hotchk155/cvocd.a/asp_config/img/cvocd.gif

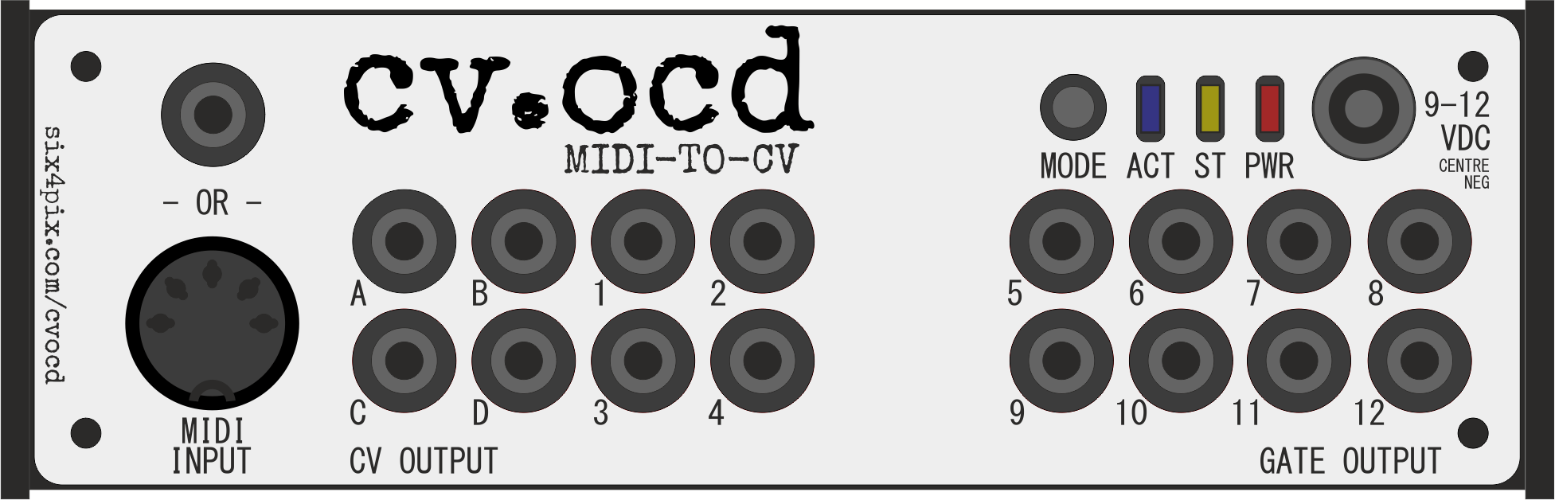
asp_config/img/cvocd.gif
