hotchk155/cvocd.a/cvocd_banana_fascia/bot-mask.bmp

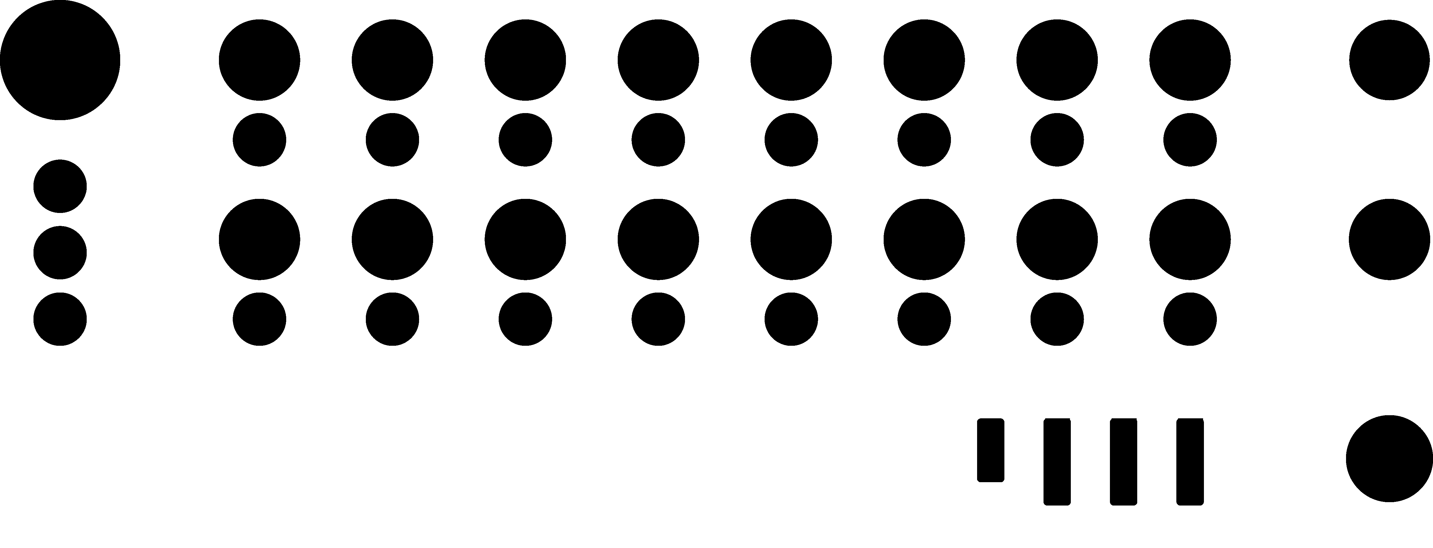
cvocd_banana_fascia/bot-mask.bmp
