hotchk155/cvocd.a/cvocd_banana_fascia/top-copper.bmp

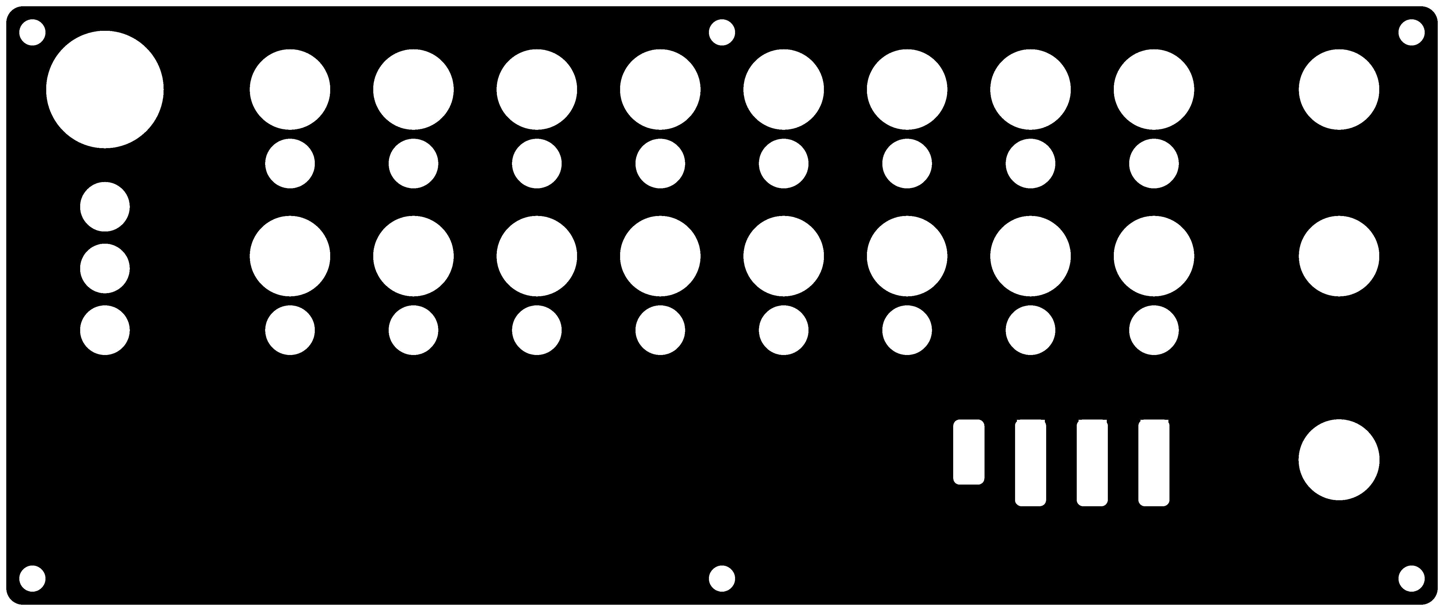
cvocd_banana_fascia/top-copper.bmp
