hotchk155/cvocd.a/cvocd_banana_fascia/top-silk.bmp

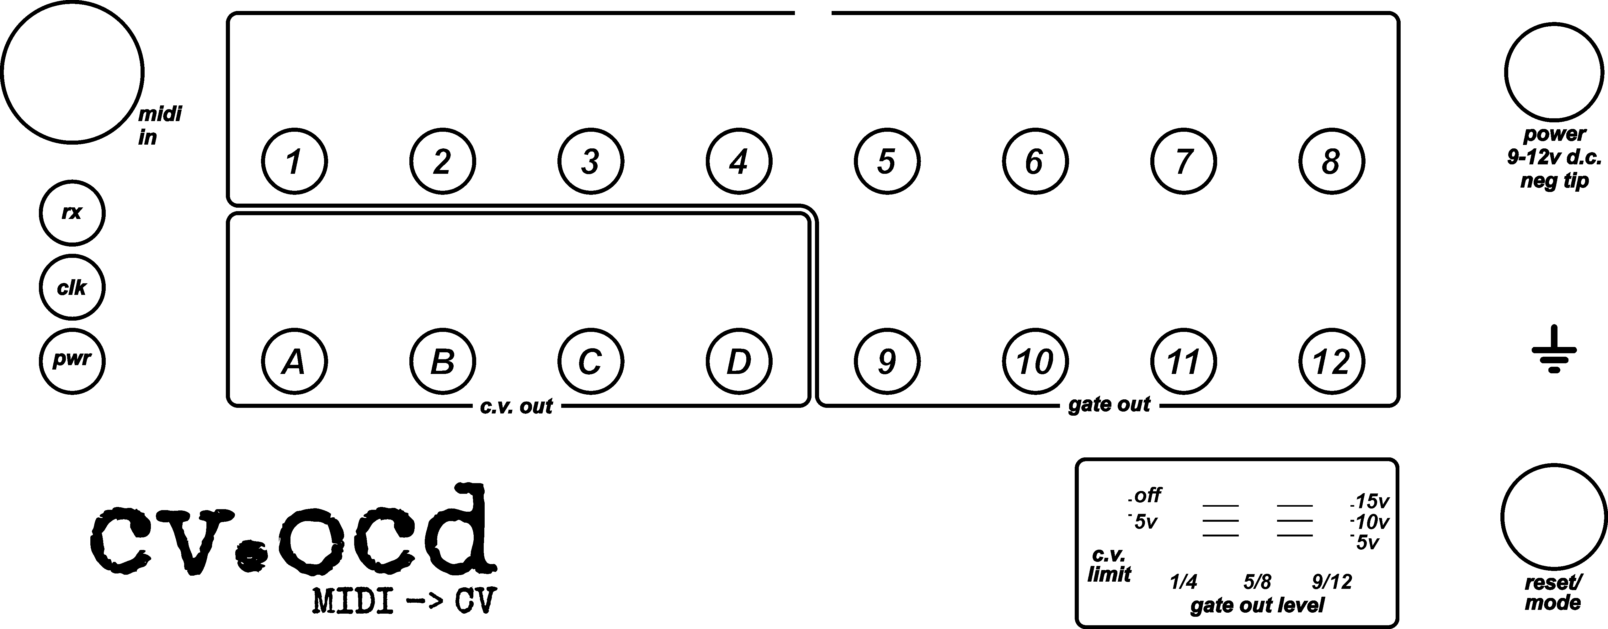
cvocd_banana_fascia/top-silk.bmp
