hotchk155/cvocd.a/hardware/cvocd.bmp

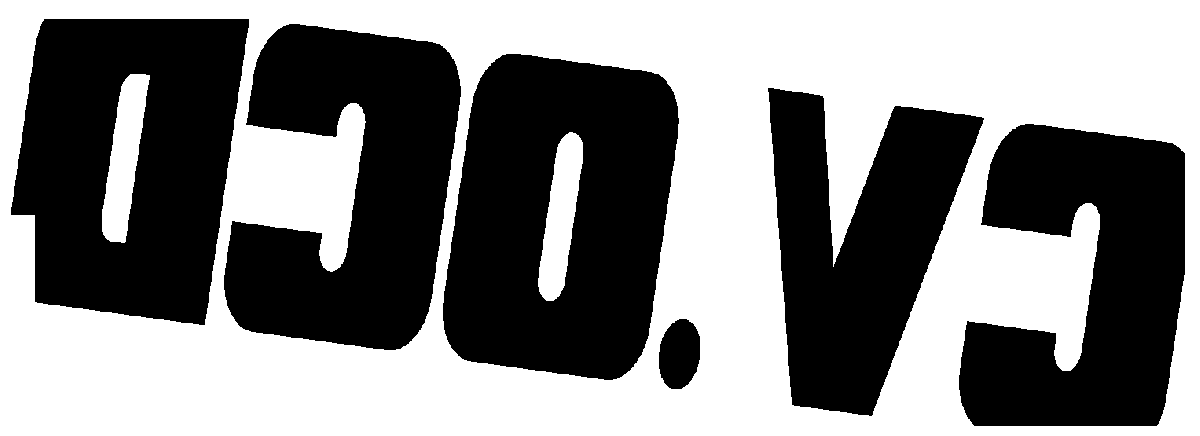
hardware/cvocd.bmp
