hotchk155/cvocd.a/cvocd_banana/cvb_bom.xlsx

Designator | Footprint |  | Quantity | Designation | 50 |  | per unit
C1, C2, C7, C8, C13, C14, C19, C20, C21, C27, C28 | C0805 | 100n | 12 | 100n | 600 | 0.02 | 0.24
C22, C23, C26, C29 | D CASE | 100uF | 4 | TAJD107K020SNTV | 200 | 0.43 | 1.72
C24, C25 | C0805 | 1uF | 2 | CL21B105KAFNNNG | 100 | 0.02 | 0.04
C3, C4, C5, C6, C9, C10, C11, C12, C15, C16, C17, C18 | C0805 | 10n | 12 | 10n | 600 | 0.2 | 2.4
CVA, CVB, CVC, CVD | 108-0910-001 |  | 4 | Banana Blue | 200 | 0.68 | 2.72
D1, D2, D3, D4 | D0805 |  | 4 | BZY55B5V1 RBG | 200 | 0.1 | 0.4
D5, D6, D7, D8, D9 | SOD123 |  | 5 | MBR0520LT | 250 | 0.09 | 0.45
GND | 108-0903-001 |  | 1 | Banana Black | 50 | 0.68 | 0.68
GT1, GT2, GT3, GT4, GT5, GT6, GT7, GT8, GT9, GT10, GT11, GT12 | 108-0902-001 |  | 12 | Banana Red | 600 | 0.65 | 7.8
IC3, IC1, IC2 | SOIC16 |  | 3 | MC14504BDR2G | 150 | 0.3 | 0.9
IC4 | SOIC14 |  | 1 | LM324BIDR | 50 | 0.12 | 0.12
IC5 | SOT223 |  | 1 | TLV76150DCYR | 50 | 0.23 | 0.23
IC6 | SOT-23-5 |  | 1 | AP3012KTR-E1 | 50 | 0.25 | 0.25
IC7 | SOT223 |  | 1 | LM317MBSTT3G | 50 | 0.2 | 0.2
L1 |  |  | 1 | TYS4012100M-10 | 50 | 0.29 | 0.29
L2 |  |  | 1 | CM322522-1R0KL | 50 | 0.15 | 0.15
LCV1, LCV2, LCV3, LCV4, LG1, LG2, LG3, LG4, LG5, LG6, LG7, LG8, LG9, LG10, LG11, LG12, LPOWER | 3258 Reverse Mount |  | 17 | LED RED | 850 | 0.06 | 1.02
LMIDI1 | 3258 Reverse Mount |  | 1 | LED BLUE | 50 | 0.06 | 0.06
LSTATUS1 | 3258 Reverse Mount |  | 1 | LED YELLOW | 50 | 0.06 | 0.06
MIDI SOCKET |  |  | 1 |  | 50 | 0.5 | 0.5
POWER SOCKET |  |  | 1 |  | 50 | 0.78 | 0.78
PUSH BUTTON |  |  | 1 |  | 50 | 1.08 | 1.08
Q2,Q1,Q4,Q3 | SOT-23 |  | 4 | 2N7002 | 200 | 0.16 | 0.64
R1, R2, R3, R4 R5, R6, R7, R8, R9, R10, R11, R12, R13, R14, R15, R16, R17, R18, R19, R20, R21, R22, R23, R24, R26, R28, R30, R32, R33, R34, R35 | R0805 |  | 31 | 1k | 1550 | 0.01 | 0.31
R25,R27,R29,R31 | R0805 |  | 4 | 4k7 | 200 | 0.01 | 0.04
R36 | R0805 |  | 1 | 22k | 50 | 0.01 | 0.01
R37 | R0805 |  | 1 | 2k | 50 | 0.01 | 0.01
R38 | R0805 |  | 1 | 470R | 50 | 0.01 | 0.01
R39 | R0805 |  | 1 | 3K3 | 50 | 0.01 | 0.01
R40 | R0805 |  | 1 | 10k | 50 | 0.01 | 0.01
SW1, SW2, SW3 | CL-SB-13B-02T |  | 3 | SW_SP3T | 150 | 0.95 | 2.85
SW4 | CL-SB-12B-01T |  | 1 | SW_SPDT | 50 | 0.65 | 0.65
Spacer | M3 20mm F/F |  | 6 |  | 300 | 0.13 | 0.78
 |  |  |  |  |  |  | 27.41
