hotchk155/cvocd.a/test-rig/cv cal setup.docx

CVOCD CALIBRATION RIG SETUP

Adjust 4.096V reference

For each output

Connect to the GND reference output

Check voltage at the lower white pin

Adjust until zero

For each output

Connect to the 4.096V reference output

Check voltage at the ADC input pin

Adjust until 2.048
