hotchk155/cvocd.a/docs/manual/img/advancednote.gif

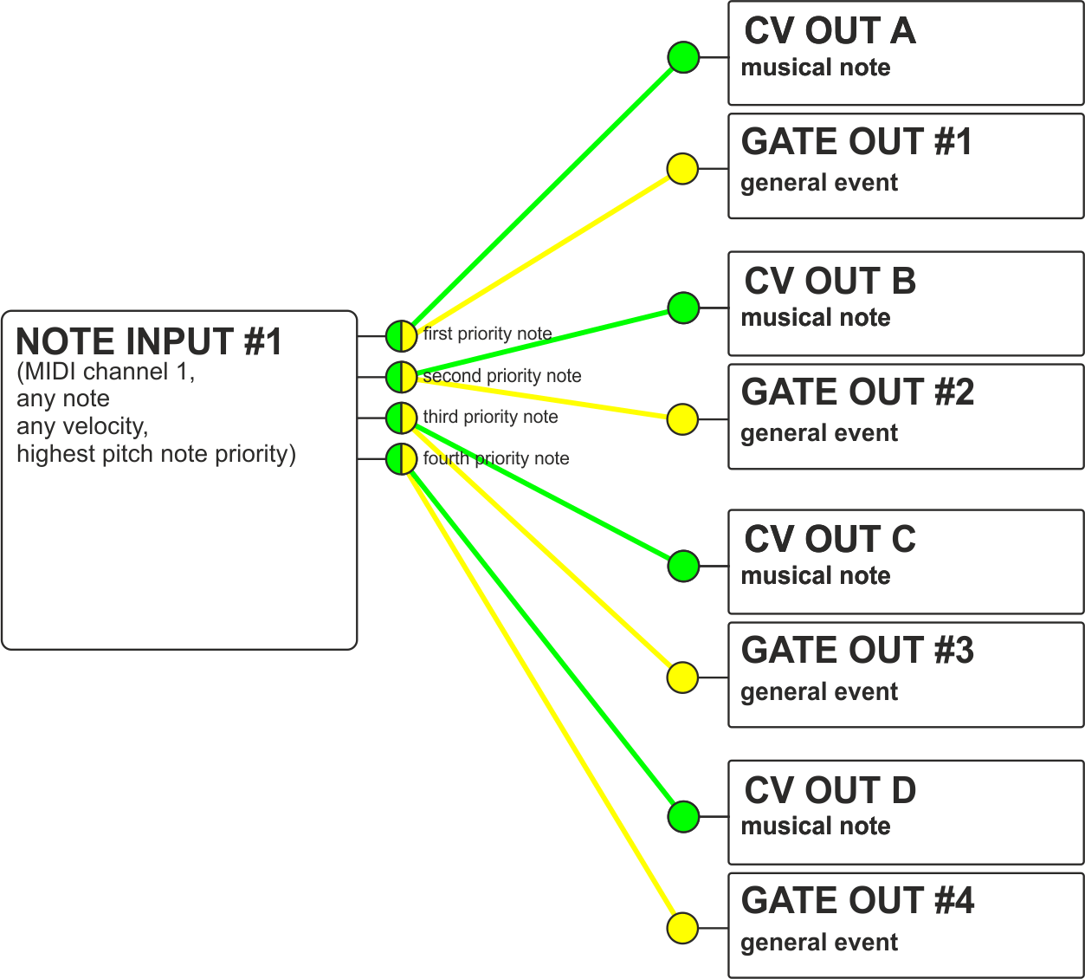
docs/manual/img/advancednote.gif
