hotchk155/cvocd.a/docs/manual/img/basicnote.gif

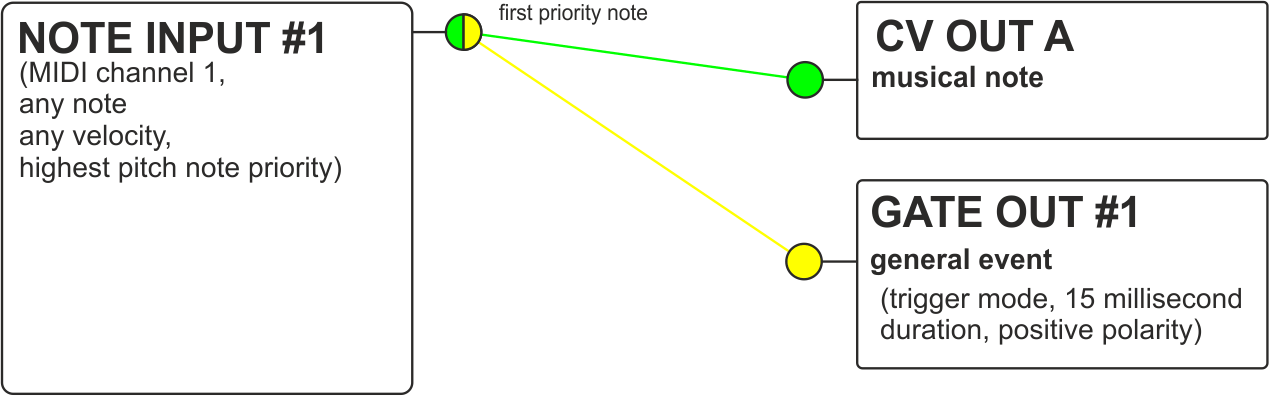
docs/manual/img/basicnote.gif
