hotchk155/cvocd.a/docs/manual/img/config1.gif

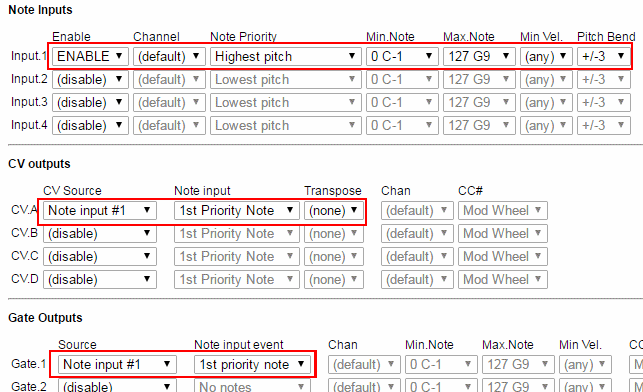
docs/manual/img/config1.gif
