hotchk155/cvocd.a/docs/manual/img/config2.gif

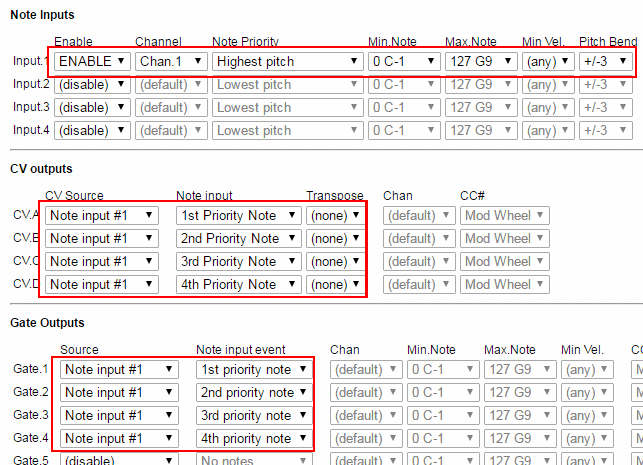
docs/manual/img/config2.gif
