hotchk155/cvocd.a/docs/manual/img/config8.gif

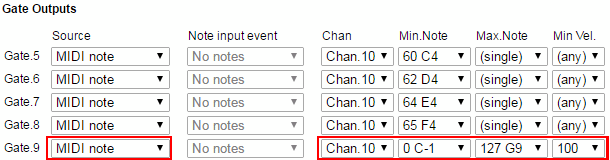
docs/manual/img/config8.gif
