hotchk155/cvocd.a/docs/manual/img/config12.gif

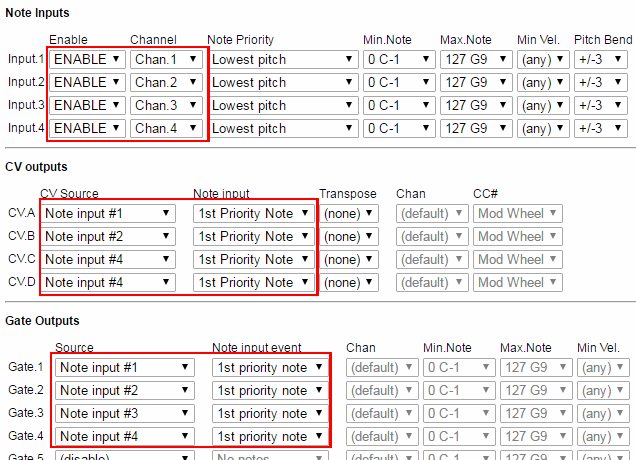
docs/manual/img/config12.gif
