hotchk155/cvocd.a/docs/manual/img/config13.gif

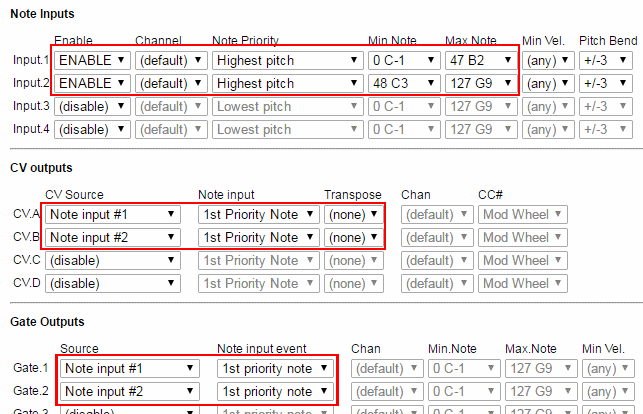
docs/manual/img/config13.gif
