hotchk155/cvocd.a/docs/manual/img/mappings.gif

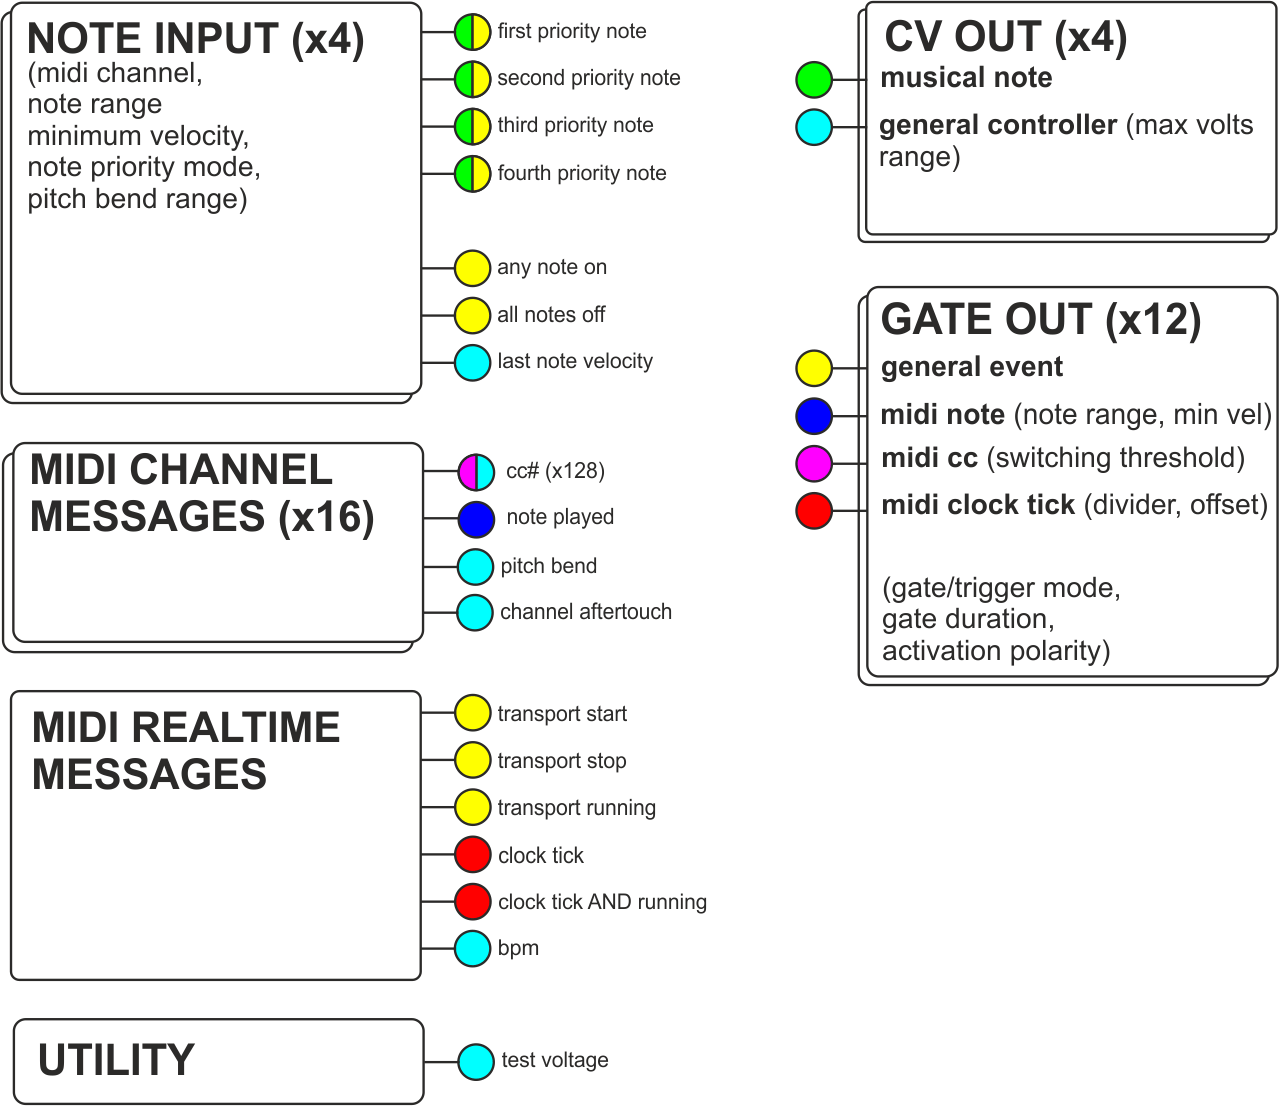
docs/manual/img/mappings.gif
