hotchk155/cvocd.a/cvocd_banana/cvocd_banana.kicad_pcb

## KiCad design cvocd_banana/cvocd_banana.kicad_pcb (2026-04-23)

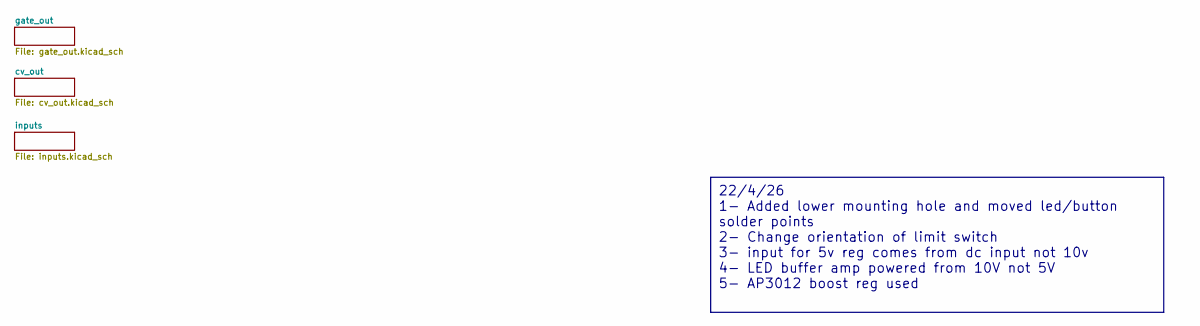
[picture p21: schematic cvocd_banana.kicad_sch]

Notes on the sheet:
22/4/26 1- Added lower mounting hole and moved led/button solder points 2- Change orientation of limit switch 3- input for 5v reg comes from dc input not 10v 4- LED buffer amp powered from 10V not 5V 5- AP3012 boost reg used

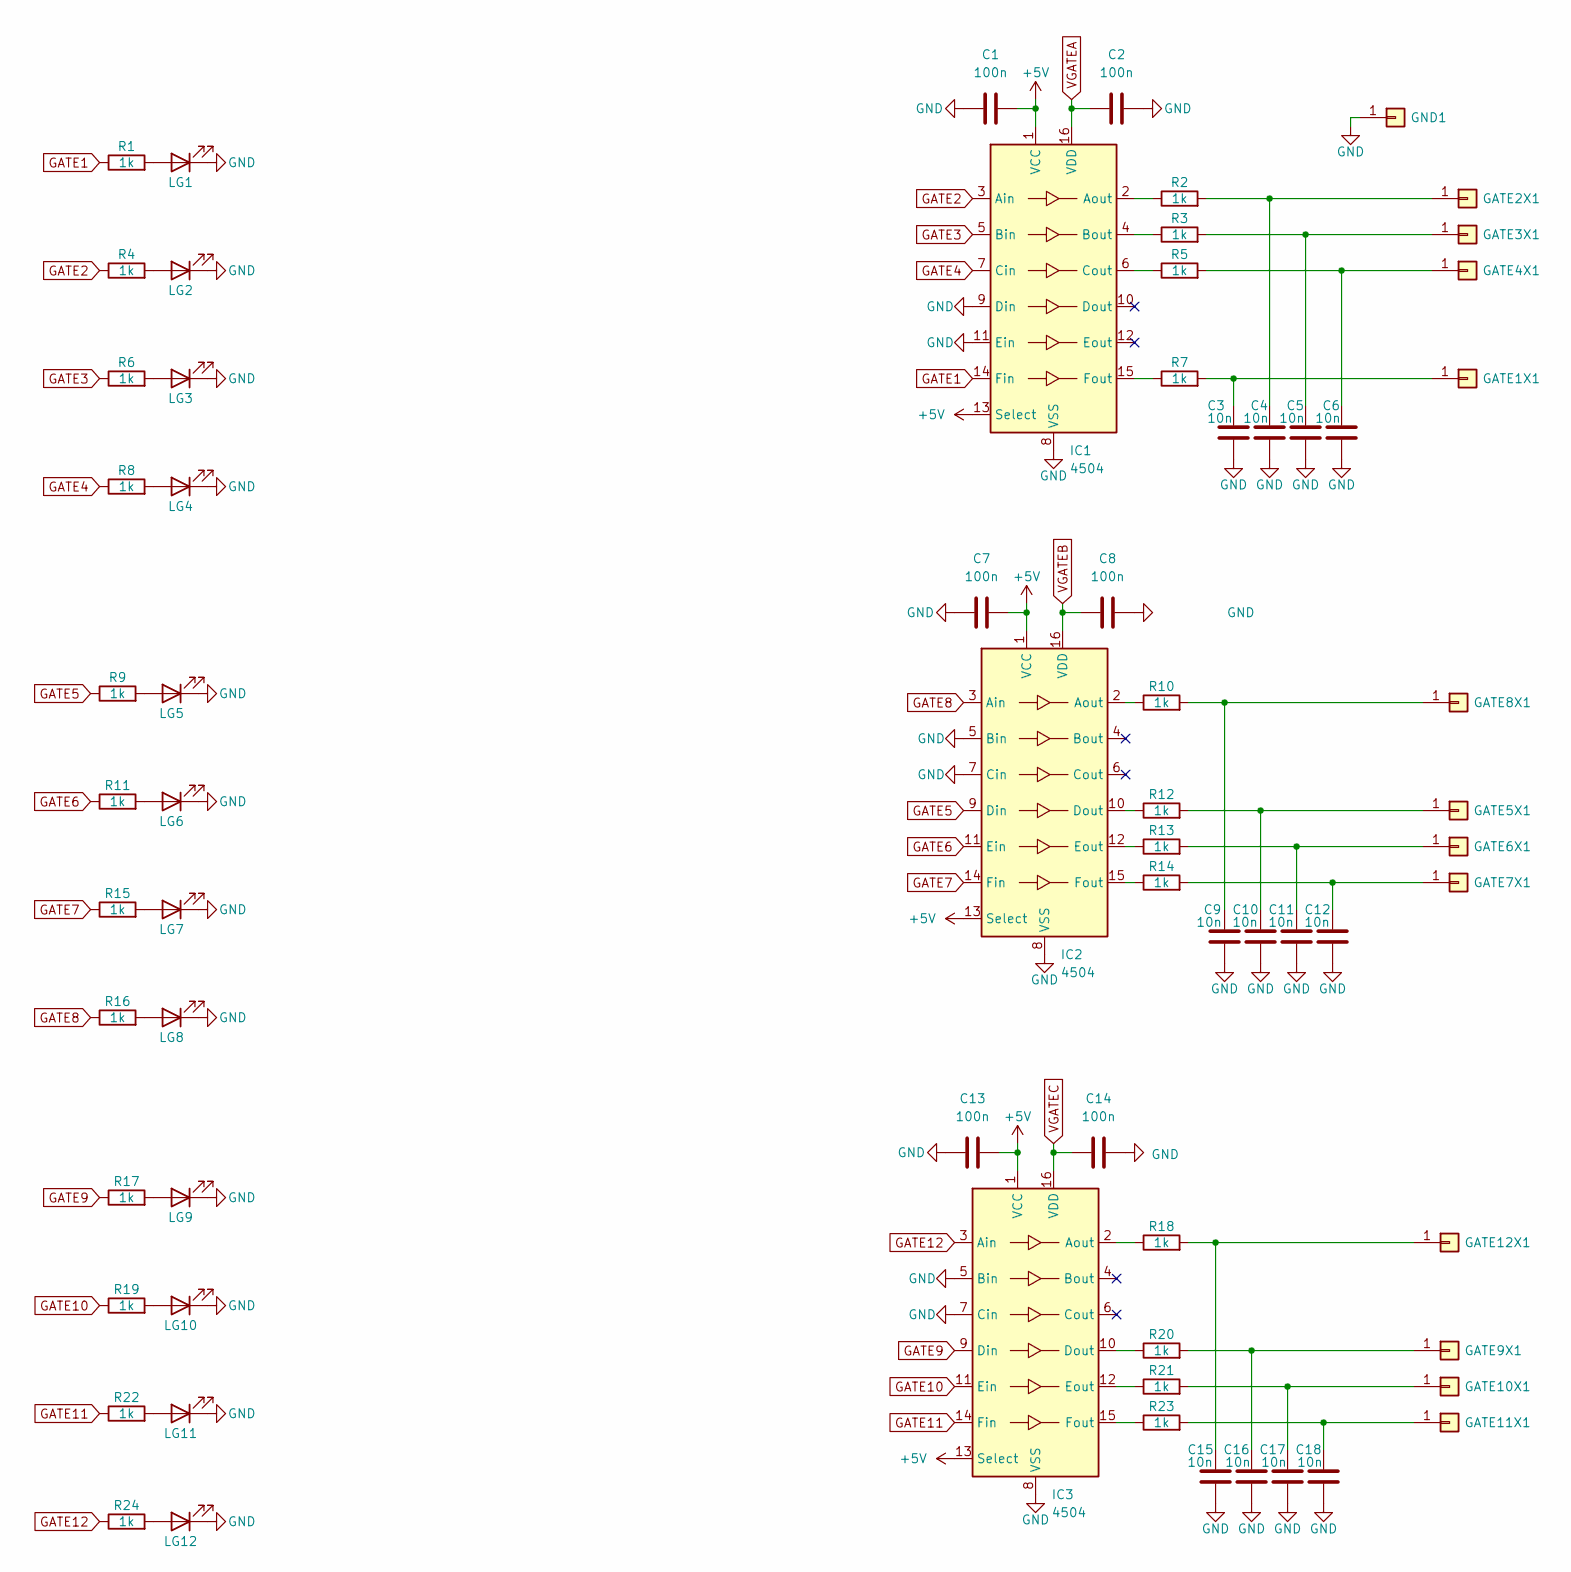
[picture p22: schematic gate_out.kicad_sch]

Parts:
C1, C2, C7, C8, C13, C14: 100n; C_0805_2012Metric
C3, C4, C5, C6, C9, C10, C11, C12, C15, C16, C17, C18: 10n; C_0805_2012Metric
GATE1X1, GATE2X1, GATE3X1, GATE4X1, GATE5X1, GATE6X1, GATE7X1, GATE8X1, GATE9X1, GATE10X1, GATE11X1, GATE12X1: Conn_01x01; CINCH-BANANA
GND1: Conn_01x01; CINCH-BANANA
IC1, IC2, IC3: 4504; SOIC-16_3.9x9.9mm_P1.27mm
LG1, LG2, LG3, LG4, LG5, LG6, LG7, LG8, LG9, LG10, LG11, LG12: LED; 3528_ReverseMount_LED
R1, R2, R3, R4, R5, R6, R7, R8, R9, R10, R11, R12, R13, R14, R15, R16, R17, R18, R19, R20, R21, R22, R23, R24: 1k; R_0805_2012Metric

Connections:
+5V: C1.2, C7.2, C13.2, IC1.1 (VCC), IC1.13 (Select), IC2.1 (VCC), IC2.13 (Select), IC3.1 (VCC), IC3.13 (Select); also elsewhere on the board
GATE1: IC1.14 (Fin), R1.1; also elsewhere on the board
GATE2: IC1.3 (Ain), R4.1; also elsewhere on the board
GATE3: IC1.5 (Bin), R6.1; also elsewhere on the board
GATE4: IC1.7 (Cin), R8.1; also elsewhere on the board
GATE5: IC2.9 (Din), R9.1; also elsewhere on the board
GATE6: IC2.11 (Ein), R11.1; also elsewhere on the board
GATE7: IC2.14 (Fin), R15.1; also elsewhere on the board
GATE8: IC2.3 (Ain), R16.1; also elsewhere on the board
GATE9: IC3.9 (Din), R17.1; also elsewhere on the board
GATE10: IC3.11 (Ein), R19.1; also elsewhere on the board
GATE11: IC3.14 (Fin), R22.1; also elsewhere on the board
GATE12: IC3.3 (Ain), R24.1; also elsewhere on the board
GND: C1.1, C2.2, C3.1, C4.1, C5.1, C6.1, C7.1, C8.2, C9.1, C10.1, C11.1, C12.1, C13.1, C14.2, C15.1, C16.1, C17.1, C18.1, GND1.1, IC1.8 (VSS), IC1.9 (Din), IC1.11 (Ein), IC2.5 (Bin), IC2.7 (Cin), IC2.8 (VSS), IC3.5 (Bin), IC3.7 (Cin), IC3.8 (VSS), LG1.1 (K), LG2.1 (K), LG3.1 (K), LG4.1 (K), LG5.1 (K), LG6.1 (K), LG7.1 (K), LG8.1 (K), LG9.1 (K), LG10.1 (K), LG11.1 (K), LG12.1 (K); also elsewhere on the board
unnamed: C3.2, GATE1X1.1, R7.2
unnamed: C4.2, GATE2X1.1, R2.2
unnamed: C5.2, GATE3X1.1, R3.2
unnamed: C6.2, GATE4X1.1, R5.2
unnamed: C10.2, GATE5X1.1, R12.2
unnamed: C11.2, GATE6X1.1, R13.2
unnamed: C12.2, GATE7X1.1, R14.2
unnamed: C9.2, GATE8X1.1, R10.2
unnamed: C16.2, GATE9X1.1, R20.2
unnamed: C17.2, GATE10X1.1, R21.2
unnamed: C18.2, GATE11X1.1, R23.2
unnamed: C15.2, GATE12X1.1, R18.2
unnamed: IC1.2 (Aout), R2.1
unnamed: IC1.4 (Bout), R3.1
unnamed: IC1.6 (Cout), R5.1
unnamed: IC1.15 (Fout), R7.1
unnamed: IC2.2 (Aout), R10.1
unnamed: IC2.10 (Dout), R12.1
unnamed: IC2.12 (Eout), R13.1
unnamed: IC2.15 (Fout), R14.1
unnamed: IC3.2 (Aout), R18.1
unnamed: IC3.10 (Dout), R20.1
unnamed: IC3.12 (Eout), R21.1
unnamed: IC3.15 (Fout), R23.1
unnamed: LG1.2 (A), R1.2
unnamed: LG2.2 (A), R4.2
unnamed: LG3.2 (A), R6.2
unnamed: LG4.2 (A), R8.2
unnamed: LG5.2 (A), R9.2
unnamed: LG6.2 (A), R11.2
unnamed: LG7.2 (A), R15.2
unnamed: LG8.2 (A), R16.2
unnamed: LG9.2 (A), R17.2
unnamed: LG10.2 (A), R19.2
unnamed: LG11.2 (A), R22.2
unnamed: LG12.2 (A), R24.2
VGATEA: C2.1, IC1.16 (VDD); also elsewhere on the board
VGATEB: C8.1, IC2.16 (VDD); also elsewhere on the board
VGATEC: C14.1, IC3.16 (VDD); also elsewhere on the board

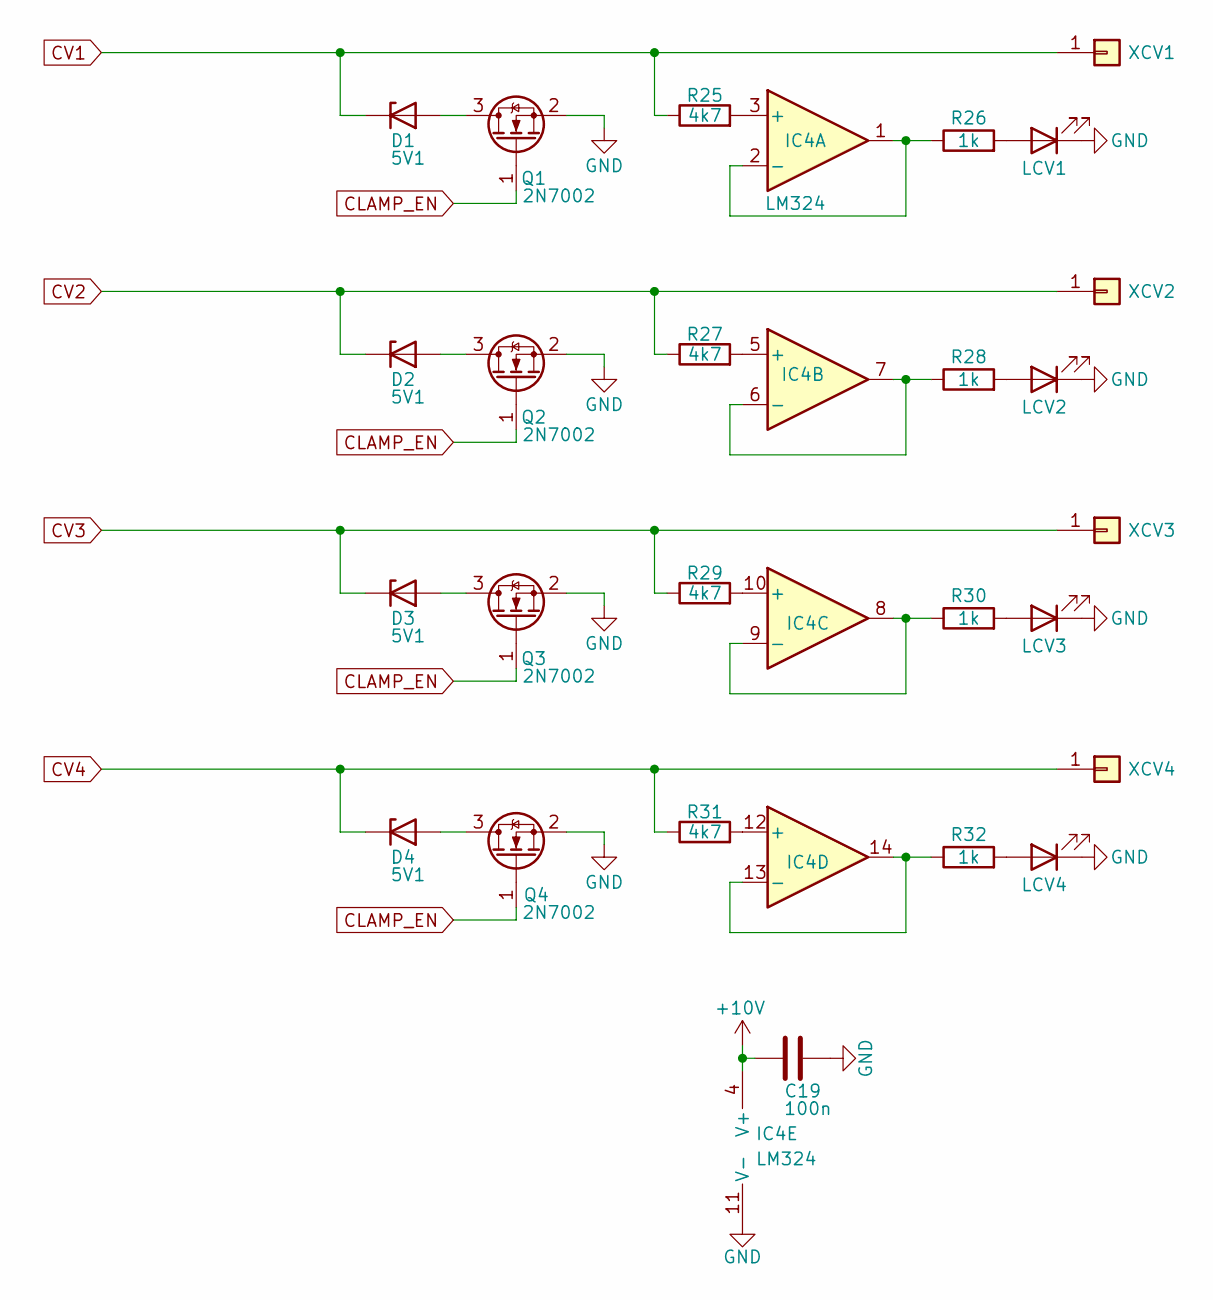
[picture p23: schematic cv_out.kicad_sch]

Parts:
C19: 100n; C_0805_2012Metric
D1, D2, D3, D4: 5V1; D_0805_2012Metric
IC4: LM324; SO-14_3.9x8.65mm_P1.27mm
LCV1, LCV2, LCV3, LCV4: LED; 3528_ReverseMount_LED
Q1, Q2, Q3, Q4: 2N7002; SOT-23
R25, R27, R29, R31: 4k7; R_0805_2012Metric
R26, R28, R30, R32: 1k; R_0805_2012Metric
XCV1, XCV2, XCV3, XCV4: Conn_01x01; CINCH-BANANA

Connections:
+10V: C19.1, IC4.4 (V+); also elsewhere on the board
CLAMP_EN: Q1.1 (G), Q2.1 (G), Q3.1 (G), Q4.1 (G); also elsewhere on the board
CV1: D1.1 (K), R25.1, XCV1.1; also elsewhere on the board
CV2: D2.1 (K), R27.1, XCV2.1; also elsewhere on the board
CV3: D3.1 (K), R29.1, XCV3.1; also elsewhere on the board
CV4: D4.1 (K), R31.1, XCV4.1; also elsewhere on the board
GND: C19.2, IC4.11 (V-), LCV1.1 (K), LCV2.1 (K), LCV3.1 (K), LCV4.1 (K), Q1.2 (S), Q2.2 (S), Q3.2 (S), Q4.2 (S); also elsewhere on the board
unnamed: D1.2 (A), Q1.3 (D)
unnamed: D2.2 (A), Q2.3 (D)
unnamed: D3.2 (A), Q3.3 (D)
unnamed: D4.2 (A), Q4.3 (D)
unnamed: IC4.3 (+), R25.2
unnamed: IC4.1, IC4.2 (-), R26.1
unnamed: IC4.5 (+), R27.2
unnamed: IC4.6 (-), IC4.7, R28.1
unnamed: IC4.10 (+), R29.2
unnamed: IC4.8, IC4.9 (-), R30.1
unnamed: IC4.12 (+), R31.2
unnamed: IC4.13 (-), IC4.14, R32.1
unnamed: LCV1.2 (A), R26.2
unnamed: LCV2.2 (A), R28.2
unnamed: LCV3.2 (A), R30.2
unnamed: LCV4.2 (A), R32.2

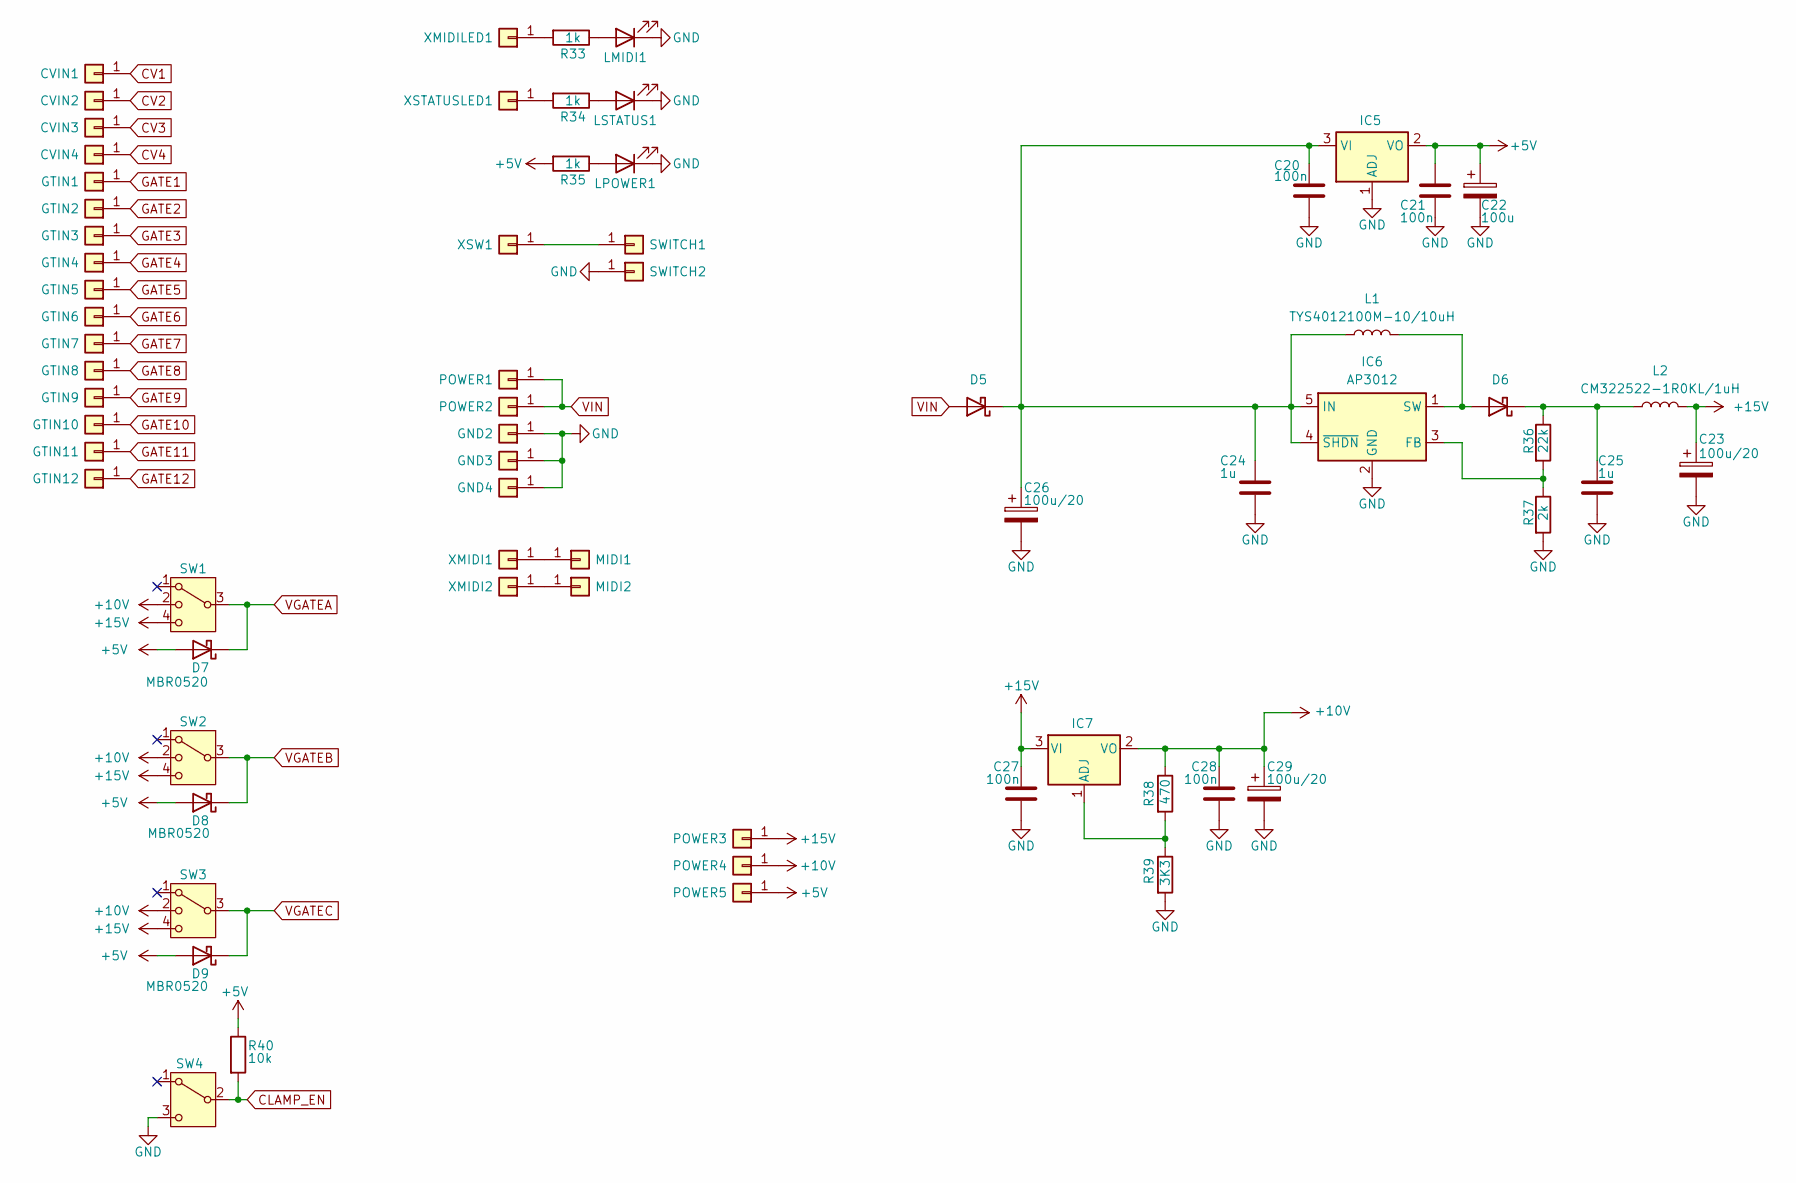
[picture p24: schematic inputs.kicad_sch]

Parts:
C20, C21, C27, C28: 100n; C_0805_2012Metric
C22: 100u; CP_EIA-7343-31_Kemet-D
C23, C26, C29: 100u/20; CP_EIA-7343-31_Kemet-D
C24, C25: 1u; C_0805_2012Metric
CVIN1, CVIN2, CVIN3, CVIN4: Conn_01x01; WireToBoardCVOCD
D5, D6: D_Schottky; D_SOD-123
D7, D8, D9: MBR0520; D_SOD-123
GND2, GND3, GND4: Conn_01x01; WireToBoardCVOCD
GTIN1, GTIN2, GTIN3, GTIN4, GTIN5, GTIN6, GTIN7, GTIN8, GTIN9, GTIN10, GTIN11, GTIN12: Conn_01x01; WireToBoardCVOCD
IC5: AMS1117; SOT-223-3_TabPin2
IC6: AP3012; SOT-23-5
IC7: LM317L_SOT-89; SOT-223-3_TabPin2
L1: TYS4012100M-10/10uH; L_Taiyo-Yuden_MD-4040
L2: CM322522-1R0KL/1uH; L_1210_3225Metric
LMIDI1: LED; 3528_ReverseMount_LED
LPOWER1: LED; 3528_ReverseMount_LED
LSTATUS1: LED; 3528_ReverseMount_LED
MIDI1, MIDI2: Conn_01x01; WireToBoardCVOCD
POWER1, POWER2, POWER3, POWER4, POWER5: Conn_01x01; WireToBoardCVOCD
R33, R34, R35: 1k; R_0805_2012Metric
R36: 22k; R_0805_2012Metric
R37: 2k; R_0805_2012Metric
R38: 470; R_0805_2012Metric
R39: 3K3; R_0805_2012Metric
R40: 10k; R_0805_2012Metric
SW1, SW2, SW3: SW_SP3T; Slide_1P3T_Rev_Mnt_CLSB13B01
SW4: SW_SPDT; Slide_1P2T_Rev_Mnt_CLSB12B01
SWITCH1, SWITCH2: Conn_01x01; WireToBoardCVOCD
XMIDI1, XMIDI2: Conn_01x01; WireToBoardCVOCD
XMIDILED1: Conn_01x01; WireToBoardCVOCD
XSTATUSLED1: Conn_01x01; WireToBoardCVOCD
XSW1: Conn_01x01; WireToBoardCVOCD

Connections:
+5V: C21.1, C22.1, D7.2 (A), D8.2 (A), D9.2 (A), IC5.2 (VO), POWER5.1, R35.2, R40.1; also elsewhere on the board
+10V: C28.1, C29.1, IC7.2 (VO), POWER4.1, R38.1, SW1.2, SW2.2, SW3.2; also elsewhere on the board
+15V: C23.1, C27.1, IC7.3 (VI), L2.2, POWER3.1, SW1.4, SW2.4, SW3.4
CLAMP_EN: R40.2, SW4.2 (B); also elsewhere on the board
CV1: CVIN1.1; also elsewhere on the board
CV2: CVIN2.1; also elsewhere on the board
CV3: CVIN3.1; also elsewhere on the board
CV4: CVIN4.1; also elsewhere on the board
GATE1: GTIN1.1; also elsewhere on the board
GATE2: GTIN2.1; also elsewhere on the board
GATE3: GTIN3.1; also elsewhere on the board
GATE4: GTIN4.1; also elsewhere on the board
GATE5: GTIN5.1; also elsewhere on the board
GATE6: GTIN6.1; also elsewhere on the board
GATE7: GTIN7.1; also elsewhere on the board
GATE8: GTIN8.1; also elsewhere on the board
GATE9: GTIN9.1; also elsewhere on the board
GATE10: GTIN10.1; also elsewhere on the board
GATE11: GTIN11.1; also elsewhere on the board
GATE12: GTIN12.1; also elsewhere on the board
GND: C20.2, C21.2, C22.2, C23.2, C24.2, C25.2, C26.2, C27.2, C28.2, C29.2, GND2.1, GND3.1, GND4.1, IC5.1 (ADJ), IC6.2 (GND), LMIDI1.1 (K), LPOWER1.1 (K), LSTATUS1.1 (K), R37.2, R39.2, SW4.3 (C), SWITCH2.1; also elsewhere on the board
unnamed: C20.1, C24.1, C26.1, D5.1 (K), IC5.3 (VI), IC6.4 (~SHDN), IC6.5 (IN), L1.1
unnamed: D6.2 (A), IC6.1 (SW), L1.2
unnamed: C25.1, D6.1 (K), L2.1, R36.1
unnamed: IC6.3 (FB), R36.2, R37.1
unnamed: IC7.1 (ADJ), R38.2, R39.1
unnamed: LMIDI1.2 (A), R33.1
unnamed: LPOWER1.2 (A), R35.1
unnamed: LSTATUS1.2 (A), R34.1
unnamed: MIDI1.1, XMIDI1.1
unnamed: MIDI2.1, XMIDI2.1
unnamed: SWITCH1.1, XSW1.1
unnamed: R33.2, XMIDILED1.1
unnamed: R34.2, XSTATUSLED1.1
VGATEA: D7.1 (K), SW1.3; also elsewhere on the board
VGATEB: D8.1 (K), SW2.3; also elsewhere on the board
VGATEC: D9.1 (K), SW3.3; also elsewhere on the board
VIN: D5.2 (A), POWER1.1, POWER2.1

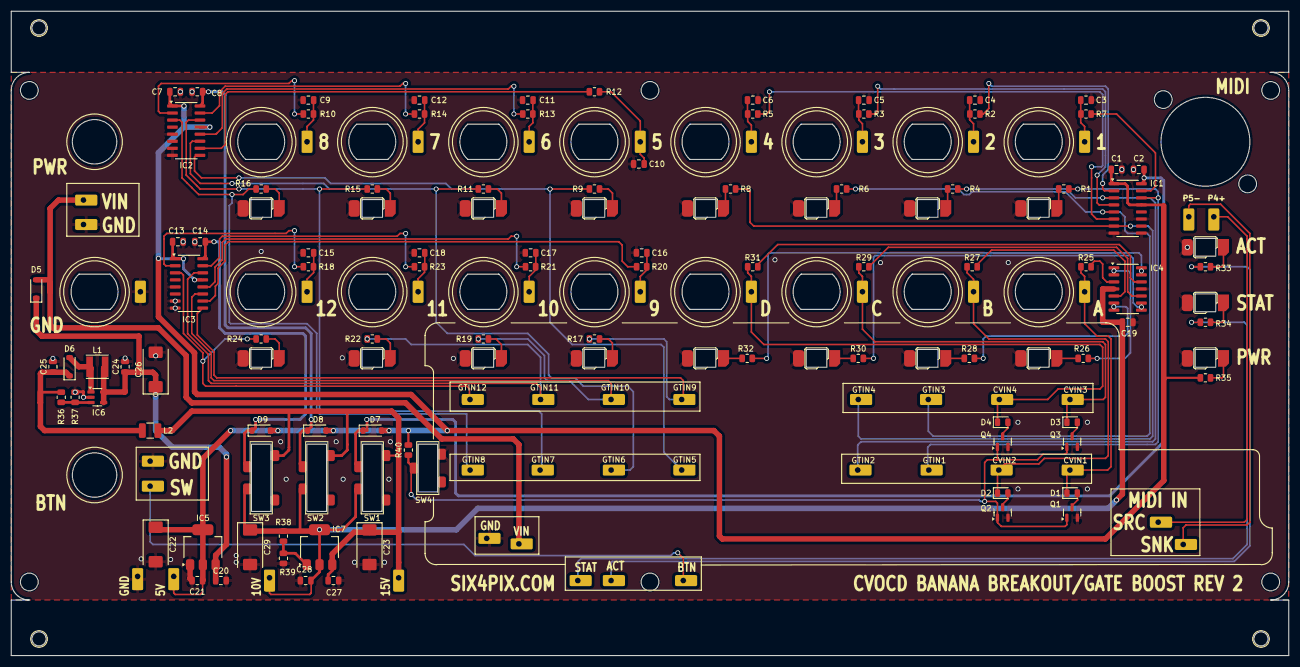
[picture p25: board cvocd_banana.kicad_pcb from above]

Board: 2 copper layers, 230.0 x 116.0 mm, 164 parts (0 on the bottom side), 90 nets.
