hotchk155/cvocd.a/hardware/cvocd-a.brd

## EAGLE design hardware/cvocd-a.brd (2020-03-26)

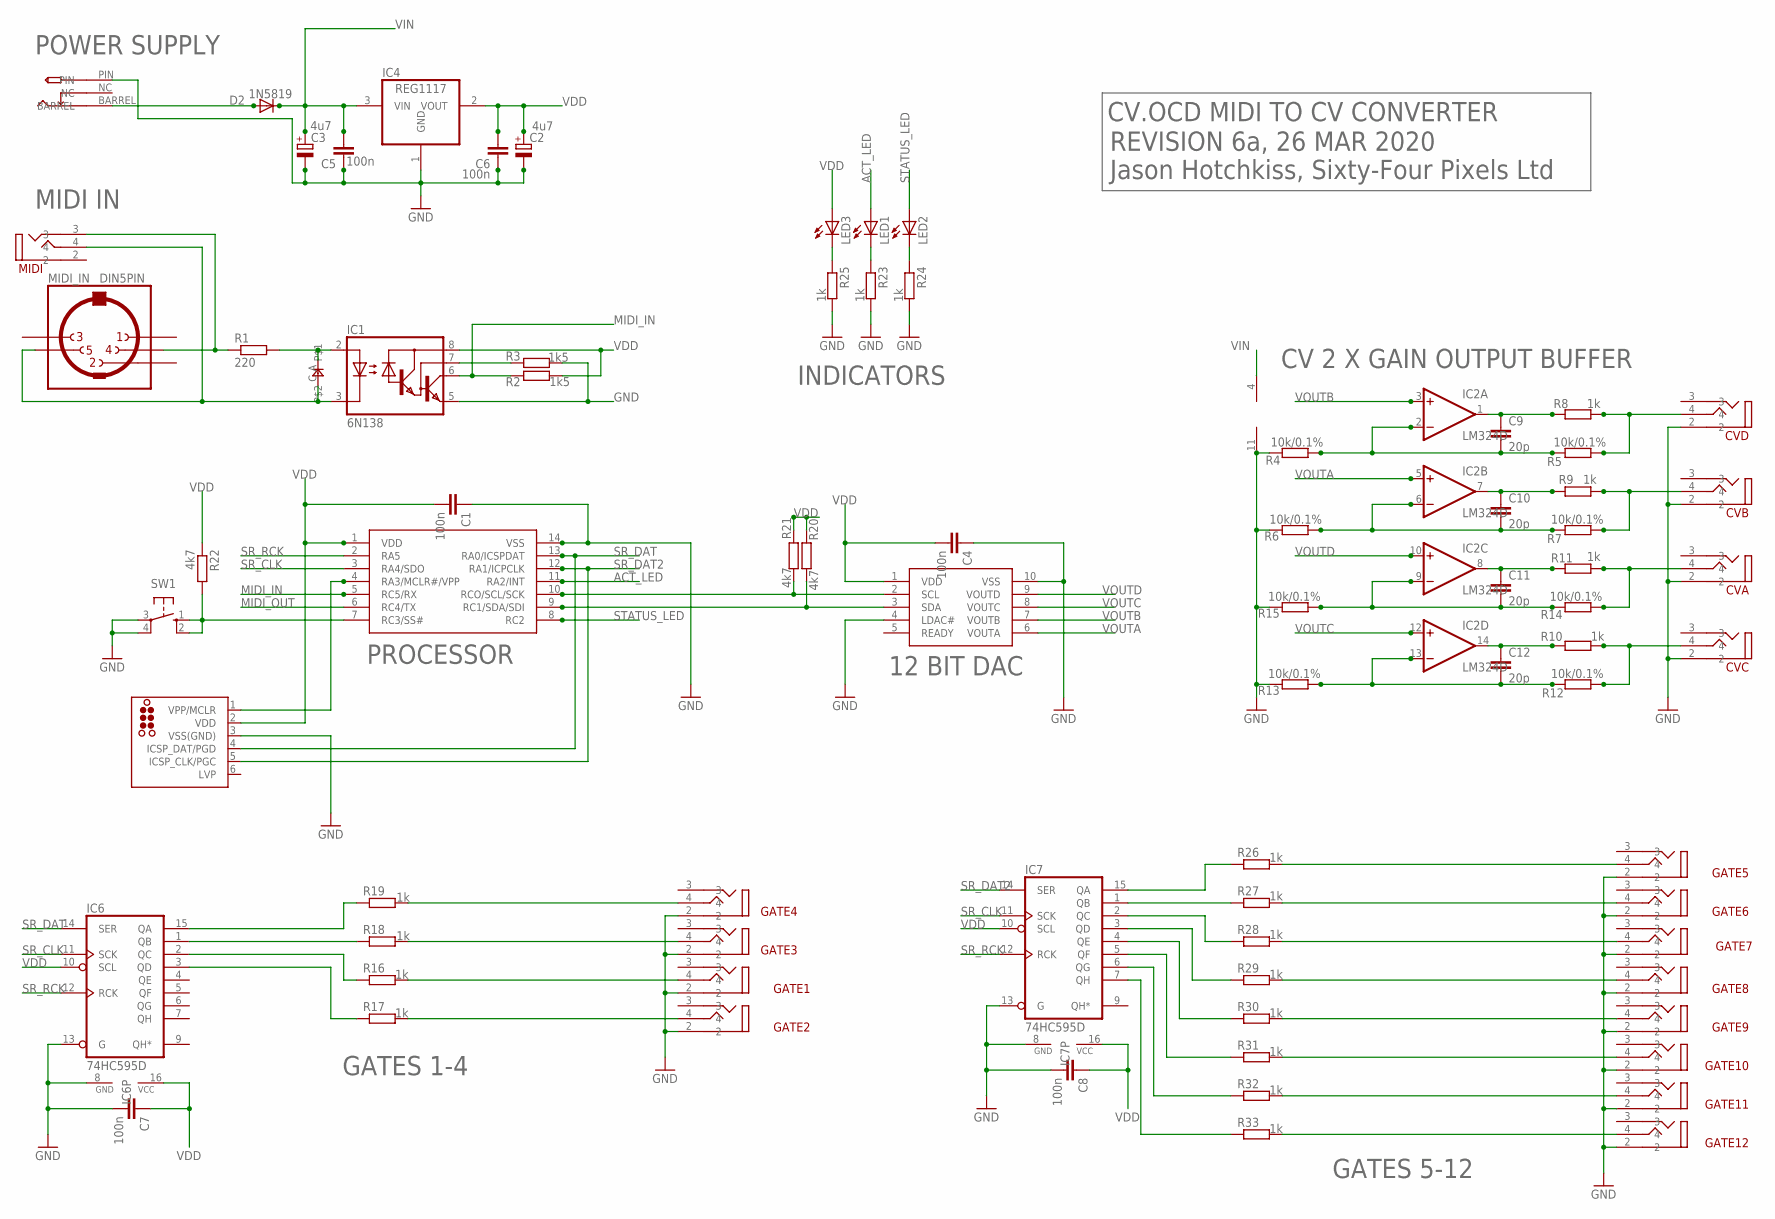
[picture p26: schematic cvocd-a.sch]

Parts:
C1, C4, C5, C6, C7, C8: 100n; C0805
C2, C3: 4u7; PANASONIC_C
C9, C10, C11, C12: 20p; C0805
CVA: VERTICAL_3_5MM_SOCKET
CVB: VERTICAL_3_5MM_SOCKET
CVC: VERTICAL_3_5MM_SOCKET
CVD: VERTICAL_3_5MM_SOCKET
D1: 0805DIODE
D2: 1N5819; SOD123
GATE1, GATE2, GATE3, GATE4, GATE5, GATE6, GATE7, GATE8, GATE9, GATE10, GATE11, GATE12: VERTICAL_3_5MM_SOCKET
IC1: 6N138; DIL08
IC2: LM324D; SO14
IC3: MCP4728_QUAD_DAC; MSOP10
IC4: REG1117; SOT223
IC5: PIC16F1825SO14; SO14
IC6, IC7: 74HC595D; SO16
ICSP: TC2030-MCP-NL
LED1, LED2, LED3: LED3MM
MIDI: VERTICAL_3_5MM_SOCKET
MIDI_IN: DIN5PIN; EDGEDIN
R1: 220; R0805
R2, R3: 1k5; R0805
R4, R5, R6, R7, R12, R13, R14, R15: 10k/0.1%; R0805
R8, R9, R10, R11, R16, R17, R18, R19, R23, R24, R25, R26, R27, R28, R29, R30, R31, R32, R33: 1k; R0805
R20, R21, R22: 4k7; R0805
SW1: 10-XX; B3F-10XX
U$2: PWR_SOCKET_2_1MM

Connections:
ACT_LED: IC5.11 (RA2/INT), LED1.A
GND: C1.1, C2.-, C3.-, C4.1, C5.1, C6.1, C7.2, C8.2, CVA.2, CVB.2, CVC.2, CVD.2, GATE1.2, GATE2.2, GATE3.2, GATE4.2, GATE5.2, GATE6.2, GATE7.2, GATE8.2, GATE9.2, GATE10.2, GATE11.2, GATE12.2, IC1.5 (GND), IC2.11 (V-), IC3.4 (LDAC#), IC3.10 (VSS), IC4.1 (GND), IC5.14 (VSS), IC6.8 (GND), IC6.13 (G), IC7.8 (GND), IC7.13 (G), ICSP.3 (VSS(GND)), R3.2, R4.1, R6.1, R13.1, R15.1, R23.2, R24.2, R25.2, SW1.3, SW1.4 (P1), U$2.PIN
MIDI_IN: IC1.6 (VO), IC5.5 (RC5/RX), R2.1
MIDI_OUT: IC5.6 (RC4/TX)
unnamed: GATE4.4, R19.2
unnamed: C9.1, IC2.1 (OUT), R8.1
unnamed: C10.1, IC2.7 (OUT), R9.1
unnamed: C11.1, IC2.8 (OUT), R11.1
unnamed: C12.1, IC2.14 (OUT), R10.1
unnamed: GATE3.4, R18.2
unnamed: GATE1.4, R16.2
unnamed: GATE2.4, R17.2
unnamed: IC5.7 (RC3/SS#), R22.2, SW1.1 (S), SW1.2 (S1)
unnamed: C9.2, IC2.2 (-IN), R4.2, R5.1
unnamed: C11.2, IC2.9 (-IN), R14.1, R15.2
unnamed: IC6.15 (QA), R19.1
unnamed: IC6.1 (QB), R18.1
unnamed: C12.2, IC2.13 (-IN), R12.1, R13.2
unnamed: IC6.3 (QD), R17.1
unnamed: IC6.2 (QC), R16.1
unnamed: CVD.4, R5.2, R8.2
unnamed: CVB.4, R7.2, R9.2
unnamed: GATE5.4, R26.2
unnamed: IC3.2 (SCL), IC5.10 (RCO/SCL/SCK), R21.2
unnamed: IC3.3 (SDA), IC5.9 (RC1/SDA/SDI), R20.2
unnamed: GATE6.4, R27.2
unnamed: GATE7.4, R28.2
unnamed: C10.2, IC2.6 (-IN), R6.2, R7.1
unnamed: MIDI.3, MIDI_IN.4, R1.1
unnamed: D1.A, IC1.2 (A), R1.2
unnamed: D1.C, IC1.3 (C), MIDI.4, MIDI_IN.5
unnamed: GATE8.4, R29.2
unnamed: GATE9.4, R30.2
unnamed: IC5.4 (RA3/MCLR#/VPP), ICSP.1 (VPP/MCLR)
unnamed: LED3.K (C), R25.1
unnamed: LED1.K (C), R23.1
unnamed: LED2.K (C), R24.1
unnamed: CVA.4, R11.2, R14.2
unnamed: GATE10.4, R31.2
unnamed: D2.A, U$2.BARREL
unnamed: GATE11.4, R32.2
unnamed: IC1.7 (VB), R3.1
unnamed: IC7.15 (QA), R26.1
unnamed: CVC.4, R10.2, R12.2
unnamed: IC7.1 (QB), R27.1
unnamed: IC7.3 (QD), R29.1
unnamed: IC7.2 (QC), R28.1
unnamed: IC7.5 (QF), R31.1
unnamed: IC7.6 (QG), R32.1
unnamed: IC7.4 (QE), R30.1
unnamed: GATE12.4, R33.2
unnamed: IC7.7 (QH), R33.1
SR_CLK: IC5.3 (RA4/SDO), IC6.11 (SCK), IC7.11 (SCK)
SR_DAT: IC5.13 (RA0/ICSPDAT), IC6.14 (SER), ICSP.4 (ICSP_DAT/PGD)
SR_DAT2: IC5.12 (RA1/ICPCLK), IC7.14 (SER), ICSP.5 (ICSP_CLK/PGC)
SR_RCK: IC5.2 (RA5), IC6.12 (RCK), IC7.12 (RCK)
STATUS_LED: IC5.8 (RC2), LED2.A
VDD: C1.2, C2.+, C4.2, C6.2, C7.1, C8.1, IC1.8 (VCC), IC3.1 (VDD), IC4.2 (VOUT), IC5.1 (VDD), IC6.10 (SCL), IC6.16 (VCC), IC7.10 (SCL), IC7.16 (VCC), ICSP.2 (VDD), LED3.A, R2.2, R20.1, R21.1, R22.1
VIN: C3.+, C5.2, D2.C, IC2.4 (V+), IC4.3 (VIN)
VOUTA: IC2.5 (+IN), IC3.6 (VOUTA)
VOUTB: IC2.3 (+IN), IC3.7 (VOUTB)
VOUTC: IC2.12 (+IN), IC3.8 (VOUTC)
VOUTD: IC2.10 (+IN), IC3.9 (VOUTD)

Notes on the sheet:
CV.OCD MIDI TO CV CONVERTER
REVISION 6a, 26 MAR 2020
Jason Hotchkiss, Sixty-Four Pixels Ltd
POWER SUPPLY
MIDI IN
PROCESSOR
12 BIT DAC
CV 2 X GAIN OUTPUT BUFFER
GATES 1-4
GATES 5-12
INDICATORS

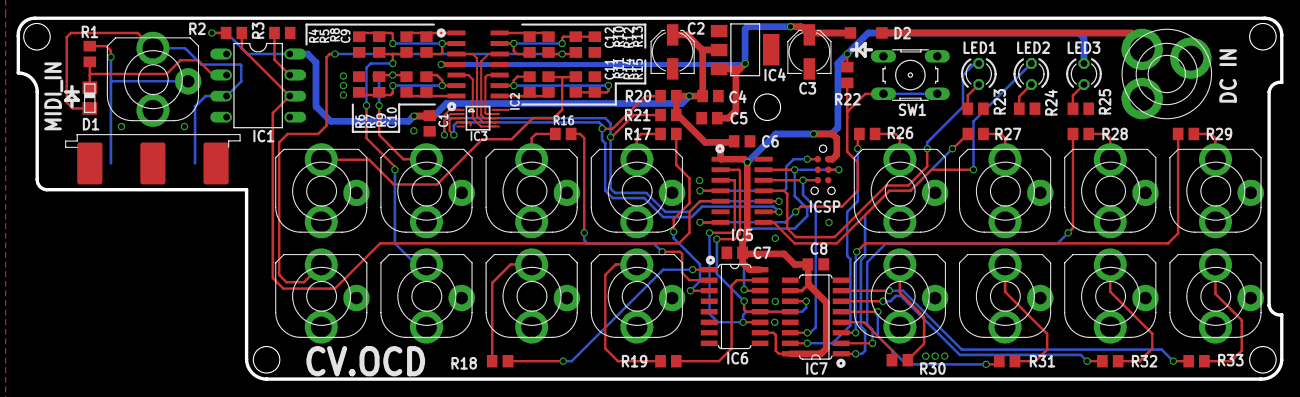
[picture p27: board cvocd-a.brd from above]

Board: 2 copper layers, 152.5 x 43.6 mm, 78 parts (0 on the bottom side), 62 nets.
