hotchk155/cvocd.a/pcb-panel/cvocd-a-panel.brd

## EAGLE design pcb-panel/cvocd-a-panel.brd (2020-03-26)

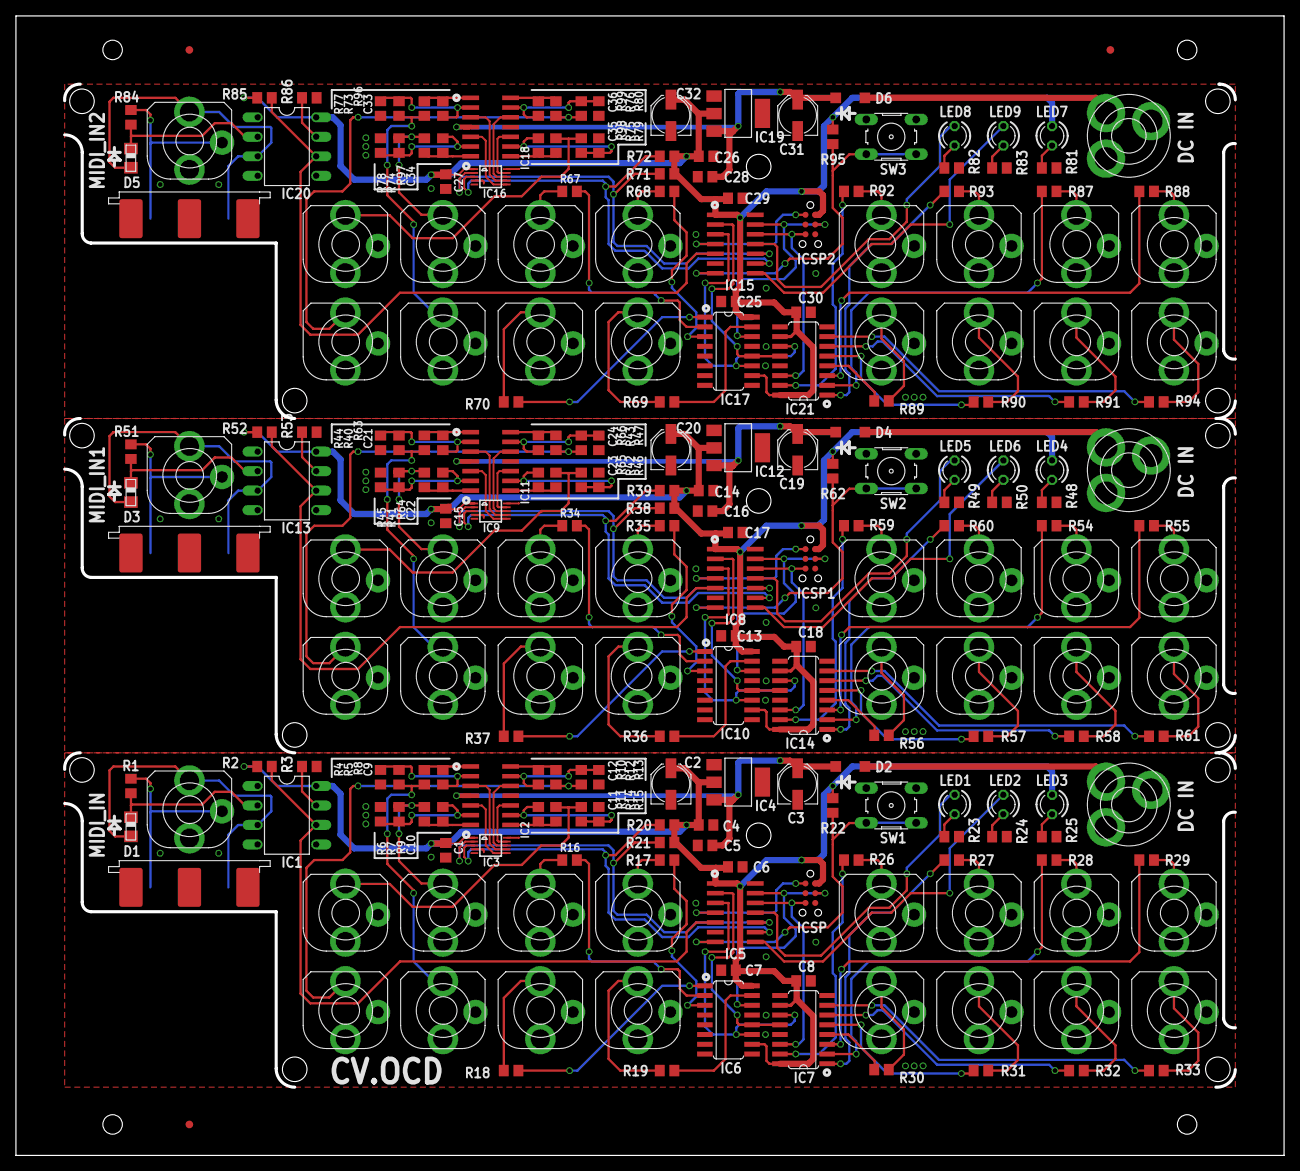
[picture p28: board cvocd-a-panel.brd from above]

Board: 2 copper layers, 165.2 x 148.5 mm, 237 parts (0 on the bottom side), 186 nets.

Parts:
C1, C4, C5, C6, C7, C8, C13, C14, C15, C16, C17, C18, C25, C26, C27, C28, C29, C30: 100n; C0805
C2, C3, C19, C20, C31, C32: 4u7; PANASONIC_C
C9, C10, C11, C12, C21, C22, C23, C24, C33, C34, C35, C36: 20p; C0805
CVA, CVA1, CVA2: VERTICAL_3_5MM_SOCKET
CVB, CVB1, CVB2: VERTICAL_3_5MM_SOCKET
CVC, CVC1, CVC2: VERTICAL_3_5MM_SOCKET
CVD, CVD1, CVD2: VERTICAL_3_5MM_SOCKET
D1, D3, D5: 0805DIODE
D2, D4, D6: 1N5819; SOD123
E$1, E$2, E$3: FIDUCIAL_1MM
GATE1, GATE2, GATE3, GATE4, GATE5, GATE6, GATE7, GATE8, GATE9, GATE10, GATE11, GATE12, GATE13, GATE14, GATE15, GATE16, GATE17, GATE18, GATE19, GATE20, GATE21, GATE22, GATE23, GATE24, GATE25, GATE26, GATE27, GATE28, GATE29, GATE30, GATE31, GATE32, GATE33, GATE34, GATE35, GATE36: VERTICAL_3_5MM_SOCKET
IC1, IC13, IC20: 6N138; DIL08
IC2, IC11, IC18: LM324D; SO14
IC3, IC9, IC16: MCP4728_QUAD_DAC; MSOP10
IC4, IC12, IC19: REG1117; SOT223
IC5, IC8, IC15: PIC16F1825SO14; SO14
IC6, IC7, IC10, IC14, IC17, IC21: 74HC595D; SO16
ICSP, ICSP1, ICSP2: TC2030-MCP-NL
LED1, LED2, LED3, LED4, LED5, LED6, LED7, LED8, LED9: LED3MM
MIDI, MIDI1, MIDI2: VERTICAL_3_5MM_SOCKET
MIDI_IN, MIDI_IN1, MIDI_IN2: DIN5PIN; EDGEDIN
R1, R51, R84: 220; R0805
R2, R3, R52, R53, R85, R86: 1k5; R0805
R4, R5, R6, R7, R12, R13, R14, R15, R40, R41, R42, R43, R44, R45, R46, R47, R73, R74, R75, R76, R77, R78, R79, R80: 10k/0.1%; R0805
R8, R9, R10, R11, R16, R17, R18, R19, R23, R24, R25, R26, R27, R28, R29, R30, R31, R32, R33, R34, R35, R36, R37, R48, R49, R50, R54, R55, R56, R57, R58, R59, R60, R61, R63, R64, R65, R66, R67, R68, R69, R70, R81, R82, R83, R87, R88, R89, R90, R91, R92, R93, R94, R96, R97, R98, R99: 1k; R0805
R20, R21, R22, R38, R39, R62, R71, R72, R95: 4k7; R0805
SW1, SW2, SW3: B3F-10XX
U$1, U$2, U$3: PWR_SOCKET_2_1MM

Connections:
ACT_LED: IC5.11, LED1.A
ACT_LED1: IC8.11, LED5.A
ACT_LED2: IC15.11, LED8.A
GND: C1.1, C2.-, C3.-, C4.1, C5.1, C6.1, C7.2, C8.2, CVA.2, CVB.2, CVC.2, CVD.2, GATE1.2, GATE2.2, GATE3.2, GATE4.2, GATE5.2, GATE6.2, GATE7.2, GATE8.2, GATE9.2, GATE10.2, GATE11.2, GATE12.2, IC1.5, IC2.11, IC3.4, IC3.10, IC4.1, IC5.14, IC6.8, IC6.13, IC7.8, IC7.13, ICSP.3, R3.2, R4.1, R6.1, R13.1, R15.1, R23.2, R24.2, R25.2, SW1.3, SW1.4, U$2.PIN
GND1: C13.2, C14.1, C15.1, C16.1, C17.1, C18.2, C19.-, C20.-, CVA1.2, CVB1.2, CVC1.2, CVD1.2, GATE13.2, GATE14.2, GATE15.2, GATE16.2, GATE17.2, GATE18.2, GATE19.2, GATE20.2, GATE21.2, GATE22.2, GATE23.2, GATE24.2, IC8.14, IC9.4, IC9.10, IC10.8, IC10.13, IC11.11, IC12.1, IC13.5, IC14.8, IC14.13, ICSP1.3, R44.1, R45.1, R46.1, R47.1, R48.2, R49.2, R50.2, R53.2, SW2.3, SW2.4, U$1.PIN
GND2: C25.2, C26.1, C27.1, C28.1, C29.1, C30.2, C31.-, C32.-, CVA2.2, CVB2.2, CVC2.2, CVD2.2, GATE25.2, GATE26.2, GATE27.2, GATE28.2, GATE29.2, GATE30.2, GATE31.2, GATE32.2, GATE33.2, GATE34.2, GATE35.2, GATE36.2, IC15.14, IC16.4, IC16.10, IC17.8, IC17.13, IC18.11, IC19.1, IC20.5, IC21.8, IC21.13, ICSP2.3, R77.1, R78.1, R79.1, R80.1, R81.2, R82.2, R83.2, R86.2, SW3.3, SW3.4, U$3.PIN
MIDI_IN: IC1.6, IC5.5, R2.1
MIDI_IN1: IC8.5, IC13.6, R52.1
MIDI_IN2: IC15.5, IC20.6, R85.1
unnamed: GATE4.4, R19.2
unnamed: C9.1, IC2.1, R8.1
unnamed: C10.1, IC2.7, R9.1
unnamed: C11.1, IC2.8, R11.1
unnamed: C12.1, IC2.14, R10.1
unnamed: GATE3.4, R18.2
unnamed: GATE1.4, R16.2
unnamed: GATE2.4, R17.2
unnamed: IC5.7, R22.2, SW1.1, SW1.2
unnamed: C9.2, IC2.2, R4.2, R5.1
unnamed: C11.2, IC2.9, R14.1, R15.2
unnamed: IC6.15, R19.1
unnamed: IC6.1, R18.1
unnamed: C12.2, IC2.13, R12.1, R13.2
unnamed: IC6.3, R17.1
unnamed: IC6.2, R16.1
unnamed: GATE13.4, R36.2
unnamed: CVD.4, R5.2, R8.2
unnamed: CVB.4, R7.2, R9.2
unnamed: GATE5.4, R26.2
unnamed: IC3.2, IC5.10, R21.2
unnamed: IC3.3, IC5.9, R20.2
unnamed: GATE6.4, R27.2
unnamed: GATE7.4, R28.2
unnamed: GATE14.4, R37.2
unnamed: C10.2, IC2.6, R6.2, R7.1
unnamed: GATE15.4, R34.2
unnamed: GATE16.4, R35.2
unnamed: MIDI.3, MIDI_IN.4, R1.1
unnamed: D1.A, IC1.2, R1.2
unnamed: D1.C, IC1.3, MIDI.4, MIDI_IN.5
unnamed: GATE8.4, R29.2
unnamed: GATE9.4, R30.2
unnamed: IC5.4, ICSP.1
unnamed: LED3.K, R25.1
unnamed: LED1.K, R23.1
unnamed: LED2.K, R24.1
unnamed: CVA.4, R11.2, R14.2
unnamed: GATE10.4, R31.2
unnamed: D2.A, U$2.BARREL
unnamed: GATE11.4, R32.2
unnamed: IC1.7, R3.1
unnamed: IC7.15, R26.1
unnamed: CVC.4, R10.2, R12.2
unnamed: IC10.15, R36.1
unnamed: IC7.1, R27.1
unnamed: IC7.3, R29.1
unnamed: IC7.2, R28.1
unnamed: IC7.5, R31.1
unnamed: IC7.6, R32.1
unnamed: IC7.4, R30.1
unnamed: GATE12.4, R33.2
unnamed: IC7.7, R33.1
unnamed: IC10.1, R37.1
unnamed: IC10.3, R35.1
unnamed: IC10.2, R34.1
unnamed: IC8.10, IC9.2, R38.2
unnamed: IC8.9, IC9.3, R39.2
unnamed: C21.1, IC11.1, R63.1
unnamed: C22.1, IC11.7, R64.1
unnamed: C23.1, IC11.8, R65.1
unnamed: C24.1, IC11.14, R66.1
unnamed: C22.2, IC11.6, R41.1, R45.2
unnamed: IC8.4, ICSP1.1
unnamed: LED4.K, R48.1
unnamed: LED5.K, R49.1
unnamed: LED6.K, R50.1
unnamed: D4.A, U$1.BARREL
unnamed: MIDI1.3, MIDI_IN1.4, R51.1
unnamed: D3.A, IC13.2, R51.2
unnamed: D3.C, IC13.3, MIDI1.4, MIDI_IN1.5
unnamed: IC13.7, R53.1
unnamed: GATE17.4, R59.2
unnamed: GATE18.4, R60.2
unnamed: GATE19.4, R54.2
unnamed: GATE20.4, R55.2
unnamed: GATE21.4, R56.2
unnamed: GATE22.4, R57.2
unnamed: GATE23.4, R58.2
unnamed: IC14.15, R59.1
unnamed: IC14.1, R60.1
unnamed: IC14.3, R55.1
unnamed: IC14.2, R54.1
unnamed: IC14.5, R57.1
unnamed: IC14.6, R58.1
unnamed: IC14.4, R56.1
unnamed: GATE24.4, R61.2
unnamed: IC14.7, R61.1
unnamed: IC8.7, R62.2, SW2.1, SW2.2
unnamed: CVD1.4, R40.2, R63.2
unnamed: CVB1.4, R41.2, R64.2
unnamed: CVA1.4, R42.2, R65.2
unnamed: CVC1.4, R43.2, R66.2
unnamed: C21.2, IC11.2, R40.1, R44.2
unnamed: C23.2, IC11.9, R42.1, R46.2
unnamed: C24.2, IC11.13, R43.1, R47.2
unnamed: GATE25.4, R69.2
unnamed: GATE26.4, R70.2
unnamed: GATE27.4, R67.2
unnamed: GATE28.4, R68.2
unnamed: IC17.15, R69.1
unnamed: IC17.1, R70.1
unnamed: IC17.3, R68.1
unnamed: IC17.2, R67.1
unnamed: IC15.10, IC16.2, R71.2
unnamed: IC15.9, IC16.3, R72.2
unnamed: C33.1, IC18.1, R96.1
unnamed: C34.1, IC18.7, R97.1
unnamed: C35.1, IC18.8, R98.1
unnamed: C36.1, IC18.14, R99.1
unnamed: C34.2, IC18.6, R74.1, R78.2
unnamed: IC15.4, ICSP2.1
unnamed: LED7.K, R81.1
unnamed: LED8.K, R82.1
unnamed: LED9.K, R83.1
unnamed: D6.A, U$3.BARREL
unnamed: MIDI2.3, MIDI_IN2.4, R84.1
unnamed: D5.A, IC20.2, R84.2
unnamed: D5.C, IC20.3, MIDI2.4, MIDI_IN2.5
unnamed: IC20.7, R86.1
unnamed: GATE29.4, R92.2
unnamed: GATE30.4, R93.2
unnamed: GATE31.4, R87.2
unnamed: GATE32.4, R88.2
unnamed: GATE33.4, R89.2
unnamed: GATE34.4, R90.2
unnamed: GATE35.4, R91.2
unnamed: IC21.15, R92.1
unnamed: IC21.1, R93.1
unnamed: IC21.3, R88.1
unnamed: IC21.2, R87.1
unnamed: IC21.5, R90.1
unnamed: IC21.6, R91.1
unnamed: IC21.4, R89.1
unnamed: GATE36.4, R94.2
unnamed: IC21.7, R94.1
unnamed: IC15.7, R95.2, SW3.1, SW3.2
unnamed: CVD2.4, R73.2, R96.2
unnamed: CVB2.4, R74.2, R97.2
unnamed: CVA2.4, R75.2, R98.2
unnamed: CVC2.4, R76.2, R99.2
unnamed: C33.2, IC18.2, R73.1, R77.2
unnamed: C35.2, IC18.9, R75.1, R79.2
unnamed: C36.2, IC18.13, R76.1, R80.2
SR_CLK: IC5.3, IC6.11, IC7.11
SR_CLK1: IC8.3, IC10.11, IC14.11
SR_CLK2: IC15.3, IC17.11, IC21.11
SR_DAT: IC5.13, IC6.14, ICSP.4
SR_DAT1: IC8.13, IC10.14, ICSP1.4
SR_DAT2: IC5.12, IC7.14, ICSP.5
SR_DAT3: IC8.12, IC14.14, ICSP1.5
SR_DAT4: IC15.13, IC17.14, ICSP2.4
SR_DAT5: IC15.12, IC21.14, ICSP2.5
SR_RCK: IC5.2, IC6.12, IC7.12
SR_RCK1: IC8.2, IC10.12, IC14.12
SR_RCK2: IC15.2, IC17.12, IC21.12
STATUS_LED: IC5.8, LED2.A
STATUS_LED1: IC8.8, LED6.A
STATUS_LED2: IC15.8, LED9.A
VDD: C1.2, C2.+, C4.2, C6.2, C7.1, C8.1, IC1.8, IC3.1, IC4.2, IC5.1, IC6.10, IC6.16, IC7.10, IC7.16, ICSP.2, LED3.A, R2.2, R20.1, R21.1, R22.1
VDD1: C13.1, C14.2, C15.2, C17.2, C18.1, C20.+, IC8.1, IC9.1, IC10.10, IC10.16, IC12.2, IC13.8, IC14.10, IC14.16, ICSP1.2, LED4.A, R38.1, R39.1, R52.2, R62.1
VDD2: C25.1, C26.2, C27.2, C29.2, C30.1, C32.+, IC15.1, IC16.1, IC17.10, IC17.16, IC19.2, IC20.8, IC21.10, IC21.16, ICSP2.2, LED7.A, R71.1, R72.1, R85.2, R95.1
VIN: C3.+, C5.2, D2.C, IC2.4, IC4.3
VIN1: C16.2, C19.+, D4.C, IC11.4, IC12.3
VIN2: C28.2, C31.+, D6.C, IC18.4, IC19.3
VOUTA: IC2.5, IC3.6
VOUTA1: IC9.6, IC11.5
VOUTA2: IC16.6, IC18.5
VOUTB: IC2.3, IC3.7
VOUTB1: IC9.7, IC11.3
VOUTB2: IC16.7, IC18.3
VOUTC: IC2.12, IC3.8
VOUTC1: IC9.8, IC11.12
VOUTC2: IC16.8, IC18.12
VOUTD: IC2.10, IC3.9
VOUTD1: IC9.9, IC11.10
VOUTD2: IC16.9, IC18.10
