hotchk155/cvocd.a/test-rig/test-rig.ino

//////////////////////////////////////////////////////////////////////////
//////////////////////////////////////////////////////////////////////////
//////////////////////////////////////////////////////////////////////////
//////////////////////////////////////////////////////////////////////////
// CVOCD / MUTANT BRIAN CALIBRATION RIG
// FIRMWARE V3
//////////////////////////////////////////////////////////////////////////
//////////////////////////////////////////////////////////////////////////
//////////////////////////////////////////////////////////////////////////
//////////////////////////////////////////////////////////////////////////
//////////////////////////////////////////////////////////////

//
// INCLUDES
//
#include <SPI.h>
#include <EEPROM.h>

//
// MACRO DEFS
//

// Pin definitions
#define P_LEDR1         21
#define P_LEDR2         19          
#define P_LEDR3         17
#define P_LEDB1         20          
#define P_LEDB2         18
#define P_LEDB3         16         
#define P_BUTTON1       22
#define P_BUTTON2       23
#define P_BUTTON3       11
#define P_SS            0
#define P_NEOC          4

// MIDI message numbers
#define MIDI_CC_NRPN_HI 		99
#define MIDI_CC_NRPN_LO 		98
#define MIDI_CC_DATA_HI 		6
#define MIDI_CC_DATA_LO 		38

// NRPNs used for configuration
#define NRPNH_GLOBAL        1
#define NRPNH_CV1		        21
#define NRPNH_CV2		        22
#define NRPNH_CV3		        23
#define NRPNH_CV4		        24
#define NRPNL_CAL_SCALE  	  98
#define NRPNL_CAL_OFS  		  99
#define NRPNL_SAVE          100

// parameters for the gain calibration process
#define GAIN_CAL_BASE_NOTE  36
#define GAIN_CAL_INTERVAL   12
#define GAIN_CAL_INTERVAL_MV ((1000.0*(GAIN_CAL_INTERVAL))/12.0)
#define GAIN_CAL_CYCLES     6

// parameters for the offset calibration process
#define OFS_CAL_BASE_NOTE  36
#define OFS_CAL_INTERVAL   12
#define OFS_CAL_BASE_MV ((1000.0*(OFS_CAL_BASE_NOTE-24))/12.0)
#define OFS_CAL_INTERVAL_MV ((1000.0*(OFS_CAL_INTERVAL))/12.0)
#define OFS_CAL_CYCLES     6

// EEPROM parameters
#define EEPROM_COOKIE_ADDR  9
#define EEPROM_COOKIE_VALUE 123
#define ADC_COMP_ADDR       10

// ADC config byte (external voltage ref, external clock, no channel scan)
#define ADC_CONFIG  0b00000110

// Number of iterations over which ADC results are averaged
#define ADC_READ_ITERATIONS 100

// Max millivolts for a "zero" reading when checking cables are correctly plugged
#define ZERO_VOLTS_THRESHOLD 100

//
// GLOBAL DATA
//

// ADC offset compensation data
int ADC_COMP[4];

// SYSEX PATCH MAPS OUTPUTS 1,2,3,4 TO RESPECTIVE MIDI CHANNEL
byte calibration_patch[] = {
0xF0, 0x00, 0x7F, 0x15, 0x01, 0x02, 0x00, 0x01, 0x01, 0x0C, 0x01, 0x0F, 0x0B, 0x01, 0x01, 0x00, 
0x0B, 0x02, 0x00, 0x01, 0x0B, 0x03, 0x00, 0x00, 0x0B, 0x04, 0x00, 0x7F, 0x0B, 0x05, 0x00, 0x01, 
0x0B, 0x07, 0x00, 0x03, 0x0B, 0x08, 0x00, 0x03, 0x0C, 0x01, 0x01, 0x00, 0x0C, 0x02, 0x00, 0x02, 
0x0C, 0x03, 0x00, 0x00, 0x0C, 0x04, 0x00, 0x7F, 0x0C, 0x05, 0x00, 0x01, 0x0C, 0x07, 0x00, 0x03, 
0x0C, 0x08, 0x00, 0x03, 0x0D, 0x01, 0x01, 0x00, 0x0D, 0x02, 0x00, 0x03, 0x0D, 0x03, 0x00, 0x00, 
0x0D, 0x04, 0x00, 0x7F, 0x0D, 0x05, 0x00, 0x01, 0x0D, 0x07, 0x00, 0x03, 0x0D, 0x08, 0x00, 0x03, 
0x0E, 0x01, 0x01, 0x00, 0x0E, 0x02, 0x00, 0x04, 0x0E, 0x03, 0x00, 0x00, 0x0E, 0x04, 0x00, 0x7F, 
0x0E, 0x05, 0x00, 0x01, 0x0E, 0x07, 0x00, 0x03, 0x0E, 0x08, 0x00, 0x03, 0x15, 0x01, 0x0B, 0x01, 
0x15, 0x10, 0x00, 0x00, 0x15, 0x0E, 0x00, 0x40, 0x16, 0x01, 0x0C, 0x01, 0x16, 0x10, 0x00, 0x00, 
0x16, 0x0E, 0x00, 0x40, 0x17, 0x01, 0x0D, 0x01, 0x17, 0x10, 0x00, 0x00, 0x17, 0x0E, 0x00, 0x40, 
0x18, 0x01, 0x0E, 0x01, 0x18, 0x10, 0x00, 0x00, 0x18, 0x0E, 0x00, 0x40, 0x1F, 0x01, 0x00, 0x00, 
0x1F, 0x0C, 0x01, 0x00, 0x20, 0x01, 0x00, 0x00, 0x20, 0x0C, 0x01, 0x00, 0x21, 0x01, 0x00, 0x00, 
0x21, 0x0C, 0x01, 0x00, 0x22, 0x01, 0x00, 0x00, 0x22, 0x0C, 0x01, 0x00, 0x23, 0x01, 0x00, 0x00, 
0x23, 0x0C, 0x01, 0x00, 0x24, 0x01, 0x00, 0x00, 0x24, 0x0C, 0x01, 0x00, 0x25, 0x01, 0x00, 0x00, 
0x25, 0x0C, 0x01, 0x00, 0x26, 0x01, 0x00, 0x00, 0x26, 0x0C, 0x01, 0x00, 0x27, 0x01, 0x00, 0x00, 
0x27, 0x0C, 0x01, 0x00, 0x28, 0x01, 0x00, 0x00, 0x28, 0x0C, 0x01, 0x00, 0x29, 0x01, 0x00, 0x00, 
0x29, 0x0C, 0x01, 0x00, 0x2A, 0x01, 0x00, 0x00, 0x2A, 0x0C, 0x01, 0x00, 0xF7
};

// SYSEX PATCH FOR CALIBRATION TEST WHICH OUTPUTS SAME CV ON EACH OUTPUT
byte test_patch[] = {
0xF0, 0x00, 0x7F, 0x15, 0x01, 0x02, 0x00, 0x01, 0x01, 0x0C, 0x01, 0x0F, 0x0B, 0x01, 0x01, 0x00, 0x0B, 0x02, 
0x00, 0x01, 0x0B, 0x03, 0x00, 0x00, 0x0B, 0x04, 0x00, 0x7F, 0x0B, 0x05, 0x00, 0x01, 0x0B, 0x07, 0x00, 0x03, 
0x0B, 0x08, 0x00, 0x03, 0x0C, 0x01, 0x00, 0x00, 0x0C, 0x02, 0x00, 0x00, 0x0C, 0x03, 0x00, 0x00, 0x0C, 0x04,
0x00, 0x00, 0x0C, 0x05, 0x00, 0x00, 0x0C, 0x07, 0x00, 0x00, 0x0C, 0x08, 0x00, 0x00, 0x0D, 0x01, 0x00, 0x00, 
0x0D, 0x02, 0x00, 0x00, 0x0D, 0x03, 0x00, 0x00, 0x0D, 0x04, 0x00, 0x00, 0x0D, 0x05, 0x00, 0x00, 0x0D, 0x07, 
0x00, 0x00, 0x0D, 0x08, 0x00, 0x00, 0x0E, 0x01, 0x00, 0x00, 0x0E, 0x02, 0x00, 0x00, 0x0E, 0x03, 0x00, 0x00, 
0x0E, 0x04, 0x00, 0x00, 0x0E, 0x05, 0x00, 0x00, 0x0E, 0x07, 0x00, 0x00, 0x0E, 0x08, 0x00, 0x00, 0x15, 0x01, 
0x0B, 0x01, 0x15, 0x10, 0x00, 0x00, 0x15, 0x0E, 0x00, 0x40, 0x16, 0x01, 0x0B, 0x01, 0x16, 0x10, 0x00, 0x00, 
0x16, 0x0E, 0x00, 0x40, 0x17, 0x01, 0x0B, 0x01, 0x17, 0x10, 0x00, 0x00, 0x17, 0x0E, 0x00, 0x40, 0x18, 0x01, 
0x0B, 0x01, 0x18, 0x10, 0x00, 0x00, 0x18, 0x0E, 0x00, 0x40, 0x1F, 0x01, 0x00, 0x00, 0x1F, 0x0C, 0x01, 0x00, 
0x20, 0x01, 0x00, 0x00, 0x20, 0x0C, 0x01, 0x00, 0x21, 0x01, 0x00, 0x00, 0x21, 0x0C, 0x01, 0x00, 0x22, 0x01, 
0x00, 0x00, 0x22, 0x0C, 0x01, 0x00, 0x23, 0x01, 0x00, 0x00, 0x23, 0x0C, 0x01, 0x00, 0x24, 0x01, 0x00, 0x00, 
0x24, 0x0C, 0x01, 0x00, 0x25, 0x01, 0x00, 0x00, 0x25, 0x0C, 0x01, 0x00, 0x26, 0x01, 0x00, 0x00, 0x26, 0x0C, 
0x01, 0x00, 0x27, 0x01, 0x00, 0x00, 0x27, 0x0C, 0x01, 0x00, 0x28, 0x01, 0x00, 0x00, 0x28, 0x0C, 0x01, 0x00, 
0x29, 0x01, 0x00, 0x00, 0x29, 0x0C, 0x01, 0x00, 0x2A, 0x01, 0x00, 0x00, 0x2A, 0x0C, 0x01, 0x00, 0xF7 
};

//////////////////////////////////////////////////////////////////////////
//////////////////////////////////////////////////////////////////////////
//////////////////////////////////////////////////////////////////////////
//////////////////////////////////////////////////////////////////////////
// EEPROM ROUTINES TO LOAD/SAVE ADC COMPENSATION DATA
//////////////////////////////////////////////////////////////////////////
//////////////////////////////////////////////////////////////////////////
//////////////////////////////////////////////////////////////////////////
//////////////////////////////////////////////////////////////////////////

//////////////////////////////////////////////////////////////////////////
// Write ADC compensation data
void write_adc_comp() {
  int addr = ADC_COMP_ADDR;
  for(int i = 0; i<4; ++i) {
    EEPROM.write(addr++, (ADC_COMP[i]&0xFF00)>>8);
    EEPROM.write(addr++, ADC_COMP[i]&0x00FF);
  }
  EEPROM.write(EEPROM_COOKIE_ADDR, EEPROM_COOKIE_VALUE);
}

//////////////////////////////////////////////////////////////////////////
// Read ADC compensation data
void read_adc_comp() {
  if(EEPROM.read(EEPROM_COOKIE_ADDR) != EEPROM_COOKIE_VALUE) {
    memset(ADC_COMP,0,sizeof ADC_COMP);
    write_adc_comp();
  }
  else {
    int addr = ADC_COMP_ADDR;
    for(int i = 0; i<4; ++i) {
      ADC_COMP[i] = ((int)EEPROM.read(addr++))<<8;
      ADC_COMP[i] |= (int)EEPROM.read(addr++);
    }    
  }
}

//////////////////////////////////////////////////////////////////////////
//////////////////////////////////////////////////////////////////////////
//////////////////////////////////////////////////////////////////////////
//////////////////////////////////////////////////////////////////////////
// ADC INTERFACE FOR THE MAX1167 ADC
//////////////////////////////////////////////////////////////////////////
//////////////////////////////////////////////////////////////////////////
//////////////////////////////////////////////////////////////////////////
//////////////////////////////////////////////////////////////////////////

// Setup the ADC
void adc_setup() {
  pinMode(P_SS, OUTPUT);
  pinMode(P_NEOC, INPUT_PULLUP);  
  SPI.begin();
  digitalWrite(P_SS, LOW);
  SPI.transfer(ADC_CONFIG); 
  digitalWrite(P_SS, HIGH);
  delay(10);   
}

// Get a single reading from a single ADC channel
unsigned int adc_read(unsigned int chan) {

  // Configure SPI clock speed
  SPI.beginTransaction(SPISettings(1000000UL, MSBFIRST, SPI_MODE0));

  // Assert chip select. Note that the ADC needs a falling edge on 
  // chip select line for every reading
  digitalWrite(P_SS, LOW);

  // Send the configuration word, pointing the ADC at the correct channel
  // The conversion starts on 3rd bit and is completed by 8th bit
  SPI.transfer(((3-chan)<<5) | ADC_CONFIG);

  // Read the two byte result
  byte b1 =  SPI.transfer(0);
  byte b0 =  SPI.transfer(0);

  // release chip select
  digitalWrite(P_SS, HIGH);  
  SPI.endTransaction();

  // Form the 16-bit result (4096 mV range), adding on the ADC compensation for the channel
  long result = ((unsigned)b1)<<8 | b0; 
  result += ADC_COMP[chan];
  if(result < 0) result = 0;
  return (unsigned int)result;
}

// Read the voltage for a channel and return as millivolts
// The result is averaged over multiple readings 
double mv_read(unsigned int chan) {
  delay(1);
  double result = adc_read(chan);  
  for(int i=1; i<ADC_READ_ITERATIONS; ++i) {
    result += adc_read(chan);
  }
  result /= ADC_READ_ITERATIONS;

  // result now holds the average of all the 16-bit readings 
  // since the original input voltage is halved before reaching the ADC, 
  // the 0-65535 range of the ADC maps to 0-8191mV input voltage
  // so we need a division by 8
  return result/8.0;
}
    
//////////////////////////////////////////////////////////////////////////
//////////////////////////////////////////////////////////////////////////
//////////////////////////////////////////////////////////////////////////
//////////////////////////////////////////////////////////////////////////
// TRANSMIT MIDI TO CVOCD
//////////////////////////////////////////////////////////////////////////
//////////////////////////////////////////////////////////////////////////
//////////////////////////////////////////////////////////////////////////
//////////////////////////////////////////////////////////////////////////

//////////////////////////////////////////////////////////////////////////
// SEND A SYSEX BLOCK
void send_sysex(byte *d, int len) {
  while(len--) {
    Serial1.write((byte)*d);    
    ++d;
    delay(1);
  }
}

//////////////////////////////////////////////////////////////////////////
// SEND NRPN MESSAGES
void send_nrpn(byte ph, byte pl, byte dh, byte dl) {
  Serial1.write((byte)0xB0);
  Serial1.write((byte)MIDI_CC_NRPN_HI);
  Serial1.write((byte)ph);

  Serial1.write((byte)0xB0);
  Serial1.write((byte)MIDI_CC_NRPN_LO);
  Serial1.write((byte)pl);

  Serial1.write((byte)0xB0);
  Serial1.write((byte)MIDI_CC_DATA_HI);
  Serial1.write((byte)dh);

  Serial1.write((byte)0xB0);
  Serial1.write((byte)MIDI_CC_DATA_LO);
  Serial1.write((byte)dl);

  delay(5);  
}

//////////////////////////////////////////////////////////////////////////
// SEND NRPN TO SET GAIN
void set_scale_adj(byte which, int amount) 
{
  if(amount > 63) amount = 63;
  if(amount < -63) amount = -63;
  send_nrpn(NRPNH_CV1 + which, NRPNL_CAL_SCALE, 0, amount + 64);
}

//////////////////////////////////////////////////////////////////////////
// SEND NRPN TO SET OFFSET
void set_ofs_adj(byte which, int amount) 
{
  if(amount > 63) amount = 63;
  if(amount < -63) amount = -63;
  send_nrpn(NRPNH_CV1 + which, NRPNL_CAL_OFS, 0, amount + 64);
}

//////////////////////////////////////////////////////////////////////////
// SEND NRPN TO COMMIT NEW VALUES
void save_calibration() 
{
  send_nrpn(NRPNH_GLOBAL, NRPNL_SAVE, 0, 0);
}

//////////////////////////////////////////////////////////////////////////
// TURN ALL NOTES OFF ON CVOCD AND SET OUTPUTS TO 0
void all_notes_off() {
  for(int i=0; i<4; ++i) {
    Serial1.write((byte)0x90|i);
    Serial1.write((byte)0);
    Serial1.write((byte)0x7f);
    delay(20);
    Serial1.write((byte)0x90|i);
    Serial1.write((byte)0);
    Serial1.write((byte)0x00);
    delay(20);
  }
}

//////////////////////////////////////////////////////////////////////////
// SEND MIDI NOTE THEN READ ALL CV OUTPUTS
void test_note(byte chan, byte note, double *mv) {
  
  // Send the note
  Serial1.write((byte)0x90|chan);
  Serial1.write((byte)note);
  Serial1.write((byte)0x7F);

  // delay to allow outputs to settle
  delay(100);

  // read the outputs. round to nearest whole mV
  mv[0] = mv_read(0);
  mv[1] = mv_read(1);
  mv[2] = mv_read(2);
  mv[3] = mv_read(3);

  // Turn the note off
  Serial1.write((byte)0x90|chan);
  Serial1.write((byte)note);
  Serial1.write((byte)0x00);
}

//////////////////////////////////////////////////////////////////////////
//////////////////////////////////////////////////////////////////////////
//////////////////////////////////////////////////////////////////////////
//////////////////////////////////////////////////////////////////////////
// GAIN CALIBRATION ROUTINES
//////////////////////////////////////////////////////////////////////////
//////////////////////////////////////////////////////////////////////////
//////////////////////////////////////////////////////////////////////////
//////////////////////////////////////////////////////////////////////////

// Try a gain adjustment on a channel and return the mean error
boolean try_gain_adjustment(byte which, int gain_adj, double& mean_error) 
{
 
  // set the requested gain adjustment
  set_scale_adj(which,gain_adj);
  set_ofs_adj(which,0);

  Serial.print("GAIN:");Serial.print(which);Serial.print(":");
  Serial.print("trying ");
  Serial.println(gain_adj);
  
  // Scan through the required number of octaves
  int note = GAIN_CAL_BASE_NOTE;
  double delta_total = 0;
  double delta = 0;
  double last_result = 0;
  for(int i=0; i<GAIN_CAL_CYCLES; ++i) {
    double mv[4];
    test_note(which,note,mv);
    for(int j=0; j<4; ++j) {
      if(j==which) {
        continue;
      }
      if(mv[j] > ZERO_VOLTS_THRESHOLD) {
        Serial.print("*** VOLTAGE ERROR *** Channel ");
        Serial.print(j);
        Serial.print(" has unexpected non-zero output of ");
        Serial.print(mv[j]);
        Serial.println(" mV - check cables are connected correctly ");
        return false;
      }
    }
    double result = mv[which];
    Serial.print("GAIN:");Serial.print(which);Serial.print(":");
    Serial.print("note ");
    Serial.print(note, DEC);
    Serial.print("->");
    Serial.print(result);
    if(i>0) {
      // get difference between this and the last result
      delta = result - last_result;
      if(abs(GAIN_CAL_INTERVAL_MV-delta) > (GAIN_CAL_INTERVAL_MV/10)) {
        Serial.print(" *** FAIL - OUT OF TOLERANCE ");
        Serial.println(delta);
        return false;
      }
      // subtract the expected 1000mV between octaves so that we get the 
      // deviation from the expected difference
      delta -= GAIN_CAL_INTERVAL_MV;
      Serial.print(" diff ");
      Serial.print(delta);

      // total up all the deviations from expected
      delta_total += delta;
    }    
    Serial.println("");
    
    // store last result
    last_result = result;
        

    // ready for the next octave
    note += GAIN_CAL_INTERVAL;
    
  }
  
  // get the mean deviation from 1V/octave across all octaves
  delta_total /= (GAIN_CAL_CYCLES-1);
  Serial.print("mean ");
  Serial.println(delta_total);
  mean_error = delta_total;  
  return true;
}

//////////////////////////////////////////////////////////////////////////
boolean gain_calibration(byte which, int &gain_adj) 
{
  double mean_error;
  gain_adj = 0;

  Serial.print("GAIN:");Serial.print(which);Serial.print(":");
  
  // establish the initial gain adjustment
  if(!try_gain_adjustment(which, 0, mean_error)) 
    return false;
  gain_adj = 0.5 - 4.0 * mean_error;
  if(gain_adj < -60 || gain_adj > 60) {
    Serial.println("*** ERROR: OUT OF TOLERANCE ***");
    return false;
  }
  Serial.print("initial adjustment ");
  Serial.println(gain_adj);  

  
  double min_mean_error = 9999999;
  int low_adj = gain_adj - 5;
  int high_adj = gain_adj + 5;
  low_adj = constrain(low_adj, -63, 63);
  high_adj = constrain(high_adj, -63, 63);
  
  // multiple attempts to find the offset value which works best
  for(int this_adj = low_adj; this_adj <= high_adj; ++this_adj) {

    if(!try_gain_adjustment(which, this_adj, mean_error)) 
      return false;
    
    // is this the best one yet?
    if(abs(mean_error) < abs(min_mean_error)) {
      min_mean_error = mean_error;
      gain_adj = this_adj;
      Serial.println("    >>>> best result so far");
    }     
  }

  // store best value
  set_scale_adj(which,gain_adj);
  Serial.println("");
  Serial.print("GAIN adjustment =");
  Serial.print(gain_adj);
  Serial.print(" with mean error of ");
  Serial.println(min_mean_error);
  return true;
}

//////////////////////////////////////////////////////////////////////////
//////////////////////////////////////////////////////////////////////////
//////////////////////////////////////////////////////////////////////////
//////////////////////////////////////////////////////////////////////////
// OFFSET CALIBRATION ROUTINES
//////////////////////////////////////////////////////////////////////////
//////////////////////////////////////////////////////////////////////////
//////////////////////////////////////////////////////////////////////////
//////////////////////////////////////////////////////////////////////////
boolean try_offset_adjustment(byte which, int offset_adj, double& mean_error) 
{
 

  Serial.print("OFS:");Serial.print(which);Serial.print(":");
  Serial.print("Trying ");
  Serial.println(offset_adj);
  set_ofs_adj(which,offset_adj);


  mean_error = 0;

  int note = OFS_CAL_BASE_NOTE;
  double expected_result = OFS_CAL_BASE_MV;
  double this_error = 0;
  for(int i=0; i<OFS_CAL_CYCLES; ++i) {
    double mv[4];
    test_note(which,note,mv);
    for(int j=0; j<4; ++j) {
      if(j==which) {
        continue;
      }
      if(mv[j] > ZERO_VOLTS_THRESHOLD) {
        Serial.print("*** VOLTAGE ERROR *** Channel ");
        Serial.print(j);
        Serial.print(" has unexpected non-zero output of ");
        Serial.print(mv[j]);
        Serial.println(" mV - check cables are connected correctly ");
        return false;
      }
    }
    double result = mv[which];
    this_error = result - expected_result;
    mean_error += this_error;
    Serial.print("OFS:");Serial.print(which);Serial.print(":");
    Serial.print("note ");
    Serial.print(note, DEC);
    Serial.print(" expected ");
    Serial.print(expected_result);
    Serial.print("->");
    Serial.print(result);
    Serial.print(" error ");
    Serial.println(this_error);
    //if(abs(this_error) > (OFS_CAL_INTERVAL_MV/5)) {
    //    Serial.println(" *** FAIL - OUT OF TOLERANCE ");
    //    return false;
    //}

    // ready for the next octave
    note += OFS_CAL_INTERVAL;
    expected_result += OFS_CAL_INTERVAL_MV;
  }
  mean_error /= OFS_CAL_CYCLES;
  Serial.print("mean ");
  Serial.println(mean_error);
  return true;
}


//////////////////////////////////////////////////////////////////////////
boolean offset_calibration(byte which, int &ofs_adj) 
{
  double mean_error;
  ofs_adj = 0;

  Serial.print("OFS:");Serial.print(which);Serial.print(":");
  
  // establish the initial gain adjustment
  if(!try_offset_adjustment(which, 0, mean_error)) 
    return false;

  // intial offset adjustment is (-e
  ofs_adj = (int)(0.5 - mean_error);

  double min_mean_error = 9999999999;
  
  if(mean_error < 0) { // voltages are too low
    ofs_adj = (int)(fabs(mean_error/2)+0.5);
  }
  else {
    ofs_adj = -(int)(fabs(mean_error/2)+0.5);
  }
  if(ofs_adj < -60 || ofs_adj > 60) {
    Serial.println("*** ERROR: OUT OF TOLERANCE ***");
    return false;
  }
  int low_adj = constrain(ofs_adj-3, -63, 63);
  int high_adj = constrain(ofs_adj+3, -63, 63);
  Serial.print("initial adjustment ");
  Serial.println(ofs_adj);  

  
  
  // multiple attempts to find the offset value which works best
  for(int this_adj = low_adj; this_adj <= high_adj; ++this_adj) {

    if(!try_offset_adjustment(which, this_adj, mean_error)) 
      return false;
    
    // is this the best one yet?
    if(abs(mean_error) < abs(min_mean_error)) {
      min_mean_error = mean_error;
      ofs_adj = this_adj;
      Serial.println("    >>>> best result so far");
    }     
  }

  // store best value
  set_ofs_adj(which,ofs_adj);
  Serial.println("");
  Serial.print("OFFSET adjustment =");
  Serial.print(ofs_adj);
  Serial.print(" with mean error of ");
  Serial.println(min_mean_error);
  return true;
}

//////////////////////////////////////////////////////////////////////////
//////////////////////////////////////////////////////////////////////////
//////////////////////////////////////////////////////////////////////////
//////////////////////////////////////////////////////////////////////////
// MAIN CALIBRATION ROUTINE
//////////////////////////////////////////////////////////////////////////
//////////////////////////////////////////////////////////////////////////
//////////////////////////////////////////////////////////////////////////
//////////////////////////////////////////////////////////////////////////
boolean calibrate() {

  int scale[4] = {0};
  int ofs[4] = {0};
  for(int i=0; i<4; ++i) {
    all_notes_off();
    if(!gain_calibration(i, scale[i])) {
        return false;
     }
    if(!offset_calibration(i, ofs[i])) {
      return false;
    }
  }
  save_calibration();
  Serial.println("Done...");
  Serial.print("scale");
  for(int i=0; i<4; ++i) {
    Serial.print(":");
    Serial.print(scale[i]);
  }
  Serial.print("; ofs");
  for(int i=0; i<4; ++i) {
    Serial.print(":");
    Serial.print(ofs[i]);
  }
  Serial.println(";");
}

//////////////////////////////////////////////////////////////////////////
//////////////////////////////////////////////////////////////////////////
//////////////////////////////////////////////////////////////////////////
//////////////////////////////////////////////////////////////////////////
// SCALE CHECKING ROUTINE
//////////////////////////////////////////////////////////////////////////
//////////////////////////////////////////////////////////////////////////
//////////////////////////////////////////////////////////////////////////
//////////////////////////////////////////////////////////////////////////
void pad(int val, int pad, boolean sign) {
  int a = fabs(val);
  if(a>=1000) pad -= 4;
  else if(a>=100) pad -= 3;
  else if(a>=10) pad -= 2;
  else --pad;
  if(sign) --pad;
  while(pad-->0) {
    Serial.print(" ");
  }
  if(sign && val>=0) {
    Serial.print("+");    
  }
  Serial.print(val, DEC);
}

//////////////////////////////////////////////////////////////////////////
// MEASURE CV FOR EACH NOTE
void scale_check() 
{  
  // re-evaluate
  int note = 36;
  double expected = 1000.0;
  double mv[4] = {   0  };
  
  //Serial.println("Calibration check");
  //all_notes_off();
  //delay(1000);

  double td0 = 0.0;
  double td1 = 0.0;
  double td2 = 0.0;
  double td3 = 0.0;
  int readings = 0;
  while(note <= 120) {
    test_note(0,note,mv);

    double d0 = mv[0]-expected;
    double d1 = mv[1]-expected;
    double d2 = mv[2]-expected;
    double d3 = mv[3]-expected;

    td0 += d0;
    td1 += d1;
    td2 += d2;
    td3 += d3;
    ++readings;
    
    pad(note,3,false);
    Serial.print(" | ");

    Serial.print(expected);
    Serial.print(" | ");
    Serial.print(mv[0]);
    Serial.print(" | ");
    Serial.print(mv[1]);
    Serial.print(" | ");
    Serial.print(mv[2]);
    Serial.print(" | ");
    Serial.print(mv[3]);
    Serial.print(" | ");
    pad((int)(0.5+d0),5,true);
    Serial.print(" | ");
    pad((int)(0.5+d1),5,true);
    Serial.print(" | ");
    pad((int)(0.5+d2),5,true);
    Serial.print(" | ");
    pad((int)(0.5+d3),5,true);

    Serial.println("");    
    expected += 1000.0/12.0;
    note ++;
  }
  
  Serial.print("CV0 error - mean ");  Serial.print(td0/readings); Serial.print(", total "); Serial.println(td0);
  Serial.print("CV1 error - mean ");  Serial.print(td1/readings); Serial.print(", total "); Serial.println(td1);
  Serial.print("CV2 error - mean ");  Serial.print(td2/readings); Serial.print(", total "); Serial.println(td2);
  Serial.print("CV3 error - mean ");  Serial.print(td3/readings); Serial.print(", total "); Serial.println(td3);
  
}

//////////////////////////////////////////////////////////////////////////
//////////////////////////////////////////////////////////////////////////
//////////////////////////////////////////////////////////////////////////
//////////////////////////////////////////////////////////////////////////
// ADC TEST ROUTINE
//////////////////////////////////////////////////////////////////////////
//////////////////////////////////////////////////////////////////////////
//////////////////////////////////////////////////////////////////////////
//////////////////////////////////////////////////////////////////////////
void adc_test() {
  int adc_test_channel = 0;
  double smoothed = -1;
  
  for(;;) {
    unsigned int result = adc_read(adc_test_channel);
    if(smoothed < 0) {
      smoothed = result;
    }
    else {
      smoothed = 0.9 * smoothed + 0.1 * result;
    }
    unsigned int value = (int)(0.5 + smoothed);    
    int error = result - value;
    int warning = 0;
    if(error < -16) {error = -16; warning = -1;}
    if(error > 16) {error = 16; warning = 1;}
    Serial.print(adc_test_channel);
    Serial.print(") ");
    if(ADC_COMP[adc_test_channel] > 0) Serial.print("+");
    Serial.print(ADC_COMP[adc_test_channel]);
    Serial.print(" ");
    Serial.print(value, DEC);
    Serial.print((warning < 0)? " <" : " [");    
    for(int i=-16; i<=16; ++i) {
      Serial.print((i==error)? "*": (i==0)? "+" : ".");
    }
    Serial.print((warning > 0)? "> " : "] ");    
    Serial.print(((long)(10.0*(smoothed/8.0))), DEC);
    Serial.print(" mV x10 ");
    
    if(warning) {
      Serial.print("***");
      Serial.print(result, DEC);
      Serial.print(" = ");
      Serial.print(((long)(10.0*(result/8.0))), DEC);
      Serial.print("mV x 10 ***");
    }
    Serial.println();
    delay(5);

    if(!digitalRead(P_BUTTON1)) {
      if(++adc_test_channel>3) {
        adc_test_channel = 0;
      }
      Serial.print(">>> Change to ADC channel ");
      Serial.println(adc_test_channel);
      delay(500);
      smoothed = -1;      
    }    

    if(!digitalRead(P_BUTTON2)) {
      ++ADC_COMP[adc_test_channel];
      write_adc_comp();      
      Serial.print(">>> Increment ADC compensation for channel ");
      Serial.println(adc_test_channel);
      delay(500);
    }

    if(!digitalRead(P_BUTTON3)) {
      --ADC_COMP[adc_test_channel];
      write_adc_comp();      
      Serial.print(">>> Decrement ADC compensation for channel ");
      Serial.println(adc_test_channel);
      delay(500);
    }
    
  }
}

//////////////////////////////////////////////////////////////////////////
//////////////////////////////////////////////////////////////////////////
//////////////////////////////////////////////////////////////////////////
//////////////////////////////////////////////////////////////////////////
// GLOBAL SETUP (ARDUINO ENTRY POINT)
//////////////////////////////////////////////////////////////////////////
//////////////////////////////////////////////////////////////////////////
//////////////////////////////////////////////////////////////////////////
//////////////////////////////////////////////////////////////////////////
void setup() {  

  // pin modes
  pinMode(P_LEDR1, OUTPUT);
  pinMode(P_LEDR2, OUTPUT);
  pinMode(P_LEDR3, OUTPUT);
  pinMode(P_LEDB1, OUTPUT);
  pinMode(P_LEDB2, OUTPUT);
  pinMode(P_LEDB3, OUTPUT);
  pinMode(P_BUTTON1, INPUT_PULLUP);
  pinMode(P_BUTTON2, INPUT_PULLUP);
  pinMode(P_BUTTON3, INPUT_PULLUP);

  
  // USB Serial 
  Serial.begin(9600);
  Serial.println("CV.OCD CALIBRATION RIG");  
  Serial.println("----------------------");  
  Serial.println("Begin");  

  // Hard serial (MIDI)
  Serial1.begin(31250);

  digitalWrite(P_LEDR1, HIGH); delay(100); digitalWrite(P_LEDR1, LOW); 
  digitalWrite(P_LEDR2, HIGH); delay(100); digitalWrite(P_LEDR2, LOW); 
  digitalWrite(P_LEDR3, HIGH); delay(100); digitalWrite(P_LEDR3, LOW); 

  // ADC
  adc_setup(); 
  read_adc_comp();

  digitalWrite(P_LEDB1, HIGH); delay(100); digitalWrite(P_LEDB1, LOW); 
  digitalWrite(P_LEDB2, HIGH); delay(100); digitalWrite(P_LEDB2, LOW); 
  digitalWrite(P_LEDB3, HIGH); delay(100); digitalWrite(P_LEDB3, LOW); 

  // If button 1 is pressed, go into ADC test mode  
  if(!digitalRead(P_BUTTON1)) {
    adc_test();  
  }
}

//////////////////////////////////////////////////////////////////////////
//////////////////////////////////////////////////////////////////////////
//////////////////////////////////////////////////////////////////////////
//////////////////////////////////////////////////////////////////////////
// GLOBAL MAIN LOOP (ARDUINO ENTRY POINT)
//////////////////////////////////////////////////////////////////////////
//////////////////////////////////////////////////////////////////////////
//////////////////////////////////////////////////////////////////////////
//////////////////////////////////////////////////////////////////////////
void loop() {

  if(!digitalRead(P_BUTTON1)) {
      digitalWrite(P_LEDR1,HIGH);
      digitalWrite(P_LEDR2,LOW);
      digitalWrite(P_LEDR3,LOW);    
      Serial.println("--- CALIBRATE ---");
      send_sysex(calibration_patch, sizeof calibration_patch);
      delay(2000);
      calibrate();
      digitalWrite(P_LEDR1,HIGH);
      digitalWrite(P_LEDR2,HIGH);
      digitalWrite(P_LEDR3,HIGH);    
  }   
  if(!digitalRead(P_BUTTON2)) {
    digitalWrite(P_LEDR1,HIGH);
    digitalWrite(P_LEDR2,LOW);
    digitalWrite(P_LEDR3,LOW);
    Serial.println("--- TEST ---");
    send_sysex(test_patch, sizeof test_patch);
    delay(2000);
    scale_check();
    digitalWrite(P_LEDR1,HIGH);
    digitalWrite(P_LEDR2,HIGH);
    digitalWrite(P_LEDR3,HIGH);
  } 
}

//
// END
//
