hotchk155/cvocd.a/(commit log)

2016-02-11 getting there
    [cv-strip.brd, cv-strip.sch]
2016-02-11 almost done?
    [cv-strip.brd, cv-strip.sch]
2016-03-05 pcb v1
    [cv-strip.brd, cv-strip.sch]
2016-03-23 add comp values
    [cv-strip.brd, cv-strip.sch]
2016-05-23 fixes
    fix pitch bend, reset cv to zero
    [cv-strip.c, cv.c, stack.c]
2016-05-23 retrigs, pitch bend cv, fixes
    [cv-strip.c, cv.c, gate.c, stack.c]
2016-05-24 test voltage, clock
2016-05-29 rev2 updates - checking needed
    [cv-strip.brd, cv-strip.sch]
2016-06-10 extra n fet on voltage select circuits
    [cv-strip.brd, cv-strip.sch]
2016-06-13 Final rev 2 release PCB
    [cv-strip.brd]
2016-06-14 REV2A
    fixed some DRC issues
    [cv-strip.brd]
2016-07-16 working on rev 3 LPC812
    [cv-strip.brd, cv-strip.sch]
2016-07-18 rev3 PCB final
    [cv-strip.brd, cv-strip.sch]
2016-07-23 label changes only
    [cv-strip.sch]
2016-08-12 Reverting master back to original PIC code for 12bit DAC
    [cv-strip.c, cv.c, gate.c]
2016-09-26 Revert "working on CV gate mode"
    This reverts commit b332149b2ce033c2ec8ef14785a9b57907feba7d.
    [cv-strip.c, cv.c, gate.c]
2016-10-14 various mods and fixes
    [cvocd.c, cvocd.h, global.c, stack.c]
2016-10-14 Slot stealing in chord mode
2017-02-12 1.3beta
    fix to CC channel handling
    [cv.c]
2017-05-20 rev2.1 Fix issue with negative transpose amounts
    [cv.c, cvocd.h]
2017-05-20 rev2.2 1.2V/oct
2017-12-09 smts moved to top of board
    [cvocd-a.brd, cvocd-a.sch]
2017-12-10 pcb bitmap
    [cvocd-a.brd]
2017-12-10 license logo
    [cvocd-a.brd]
2017-12-10 tidy up silk
    [cvocd-a.brd, cvocd-a.sch]
2017-12-30 icsp to top layer, current lim resistors
    [cvocd-a.brd, cvocd-a.sch]
2018-01-02 adding teensy test rig sketch
2018-01-03 3.1 beta - add calibration features / temp remove BPM->CV
2018-01-22 V3 possible final..
    [cvocd-a.brd]
2018-01-23 Revert "aaa"
    This reverts commit 3954c3311754772a76ec03b990afd23774723b60.
    [test-rig.ino]
2018-01-28 working on v4
    [cvocd-a.brd, cvocd-a.sch]
2018-01-30 REV4 RELEASE CANDIDATE
    [cvocd-a.brd, cvocd-a.sch]
2018-02-19 v5 board first version
    [cvocd-a.brd, cvocd-a.sch]
2018-02-22 v5 pcb release candidate
    [cvocd-a.brd, cvocd-a.sch]
2018-03-12 V5.1 SILK SCREEN UPDATES
    [cvocd-a.brd, cvocd-a.sch]
2018-05-24 Fix issue with skipping system common messages with parameters
    [cvocd.c, cvocd.h]
2018-07-19 before new board
2018-09-10 rev 4.1 beta
    correct an issue where midi note gates could trigger on any note when on same midi channel as a note input
    [gate.c]
2019-02-25 5.1BETA
    Improvement to monophonic note modes to allow paraphonic operation. Fix stuck note gate issue due to deferred gate on events
    [gate.c, stack.c]
2020-01-17 V6 candidate
    change polarity on mini midi in socket
    [cvocd-a.brd, cvocd-a.sch]
2020-03-26 REV 6A - Diode direction marking only
    [cvocd-a.brd, cvocd-a.sch]
2020-06-28 PCB front panel
    [cvocd-a_centroid.csv, cvocd-fascia.kicad_pcb]
2025-04-09 test firmware update
    [cvocd_cal.xlsx]
2026-03-26 banana board in progress
    [cv_out.kicad_sch, cvocd_banana.kicad_pcb, cvocd_banana.kicad_sch, gate_out.kicad_sch, inputs.kicad_sch]
2026-03-27 updates to banana pcb
    [cv_out.kicad_sch, cvocd_banana.kicad_pcb, inputs.kicad_sch]
2026-03-28 pcb and fascia version 1
    [cvocd_banana.kicad_pcb, cvocd_banana_fascia.kicad_pcb]
2026-04-17 additional mounting holes on fascia
    [cvocd_banana_fascia.kicad_pcb]
2026-04-21 banana updates
    [cv_out.kicad_sch, cvocd_banana.kicad_pcb, cvocd_banana.kicad_sch, inputs.kicad_sch]
2026-04-22 banana pcb main v2
    [cv_out.kicad_sch, cvb_bom.xlsx, cvocd_banana.csv, cvocd_banana.kicad_pcb, cvocd_banana.kicad_sch, cvocd_banana_fascia.kicad_pcb, gate_out.kicad_sch, inputs.kicad_sch]
2026-04-23 PCB V2
    [cvocd_banana.kicad_pcb, cvocd_banana_fascia.kicad_pcb]
